GEAR-EST/SEGUIDOR-2026/README.md

# SEGUIDOR-2026

O Seguidor 2026 é um projeto de robô autonômo feito pelo [Grupo de Estudos Aplicados à Robótica (GEAR)](https://github.com/GEAR-EST) para competir na [Robocore Experience](https://www.robocoreexperience.com/) nas categorias de Seguidor de Linha ([Pro](misc/editais/Regras+-+Seguidor+de+Linha.pdf) e [Perseguidor](misc/editais/Regras+-+Perseguidor+de+Linha.pdf)).

> **Para saber mais sobre o projeto, acesse a documentação em [/docs](/docs/).**

## Organização do Repositório

```
SEGUIDOR-2026/
├── code/                       # Toda a implementação de algoritmos
│
├── docs/                       # Documentação técnica do projeto
│
├── electronics/                # Toda a parte eletrônica do robô
│
├── interface/                  # Toda a parte da interface de comunicação sem fio
│
├── mechanics/                  # Toda a parte mecânica do robô
│
├── misc/                       # Miscelânea, arquivos sem categoria definida
│
└── README.md --> ESTE ARQUIVO  # Resumo geral e organização dos diretórios
```
