GEAR-EST/SEGUIDOR-2026/misc/estudos/eletrônica/Pinout.md

Aqui está um estudo sobre o pinout como deve ser feito o diagrama de Pinout. Deve ser feito para que as constantes sejam definidas na programação e para que fique mais visível e fácil a montagem mecânica. Se possível, colocar uma descrição aos principais pinos e qual a função deles. Exemplo abaixo:

Pinout ESP32:

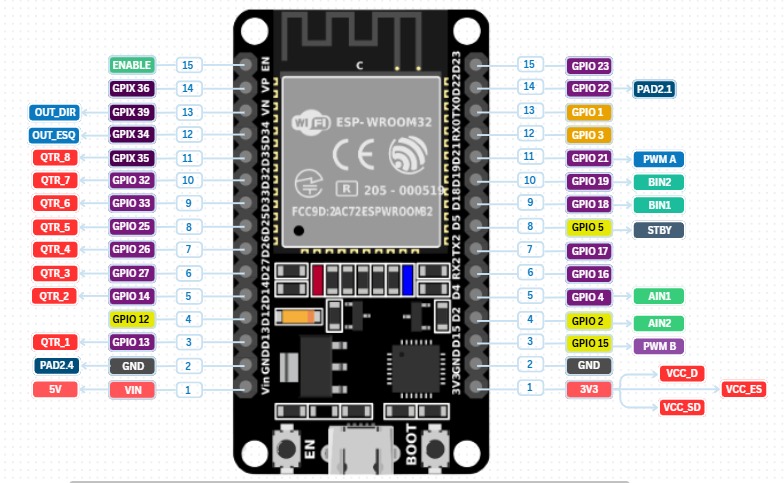
[picture p58: misc/estudos/media/img/pinnout_Esp32.jpeg]


Pinout TB6612FNG:

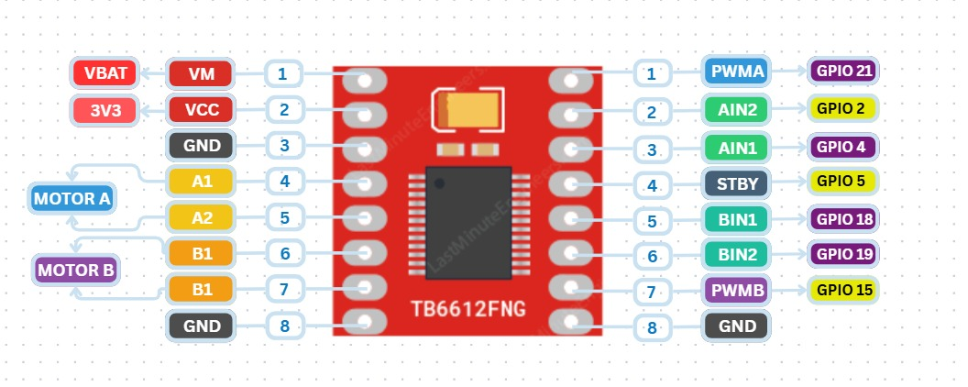
[picture p59: misc/estudos/media/img/pinout_TB6612FNG.jpeg]


Pinout Bateria LiPo 2S 7,4 V 20C 250 mAh:



Pinout Array sensor de linha QTR-8RC:

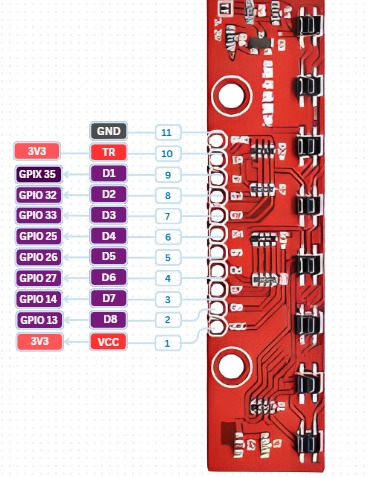
[picture p60: misc/estudos/media/img/pinout_QTR-8RC.jpeg]


Pinout TCRT5000:

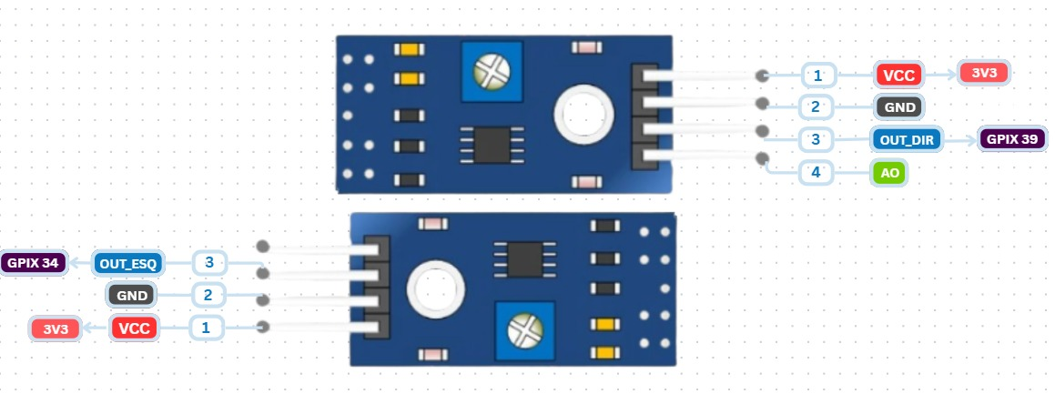
[picture p61: misc/estudos/media/img/pinout_TCRT5000.jpeg]


Pinout Motor N20 3000RPM:



Pinout Motor Coreless 8523 (7,4 V)



Pinout Transistor MOSFET IRLZ44N:



Pinout Diodo 1N4007:



Pinout Chave Switch:



Pinout Capacitores Cerâmicos e eletrolídeos:

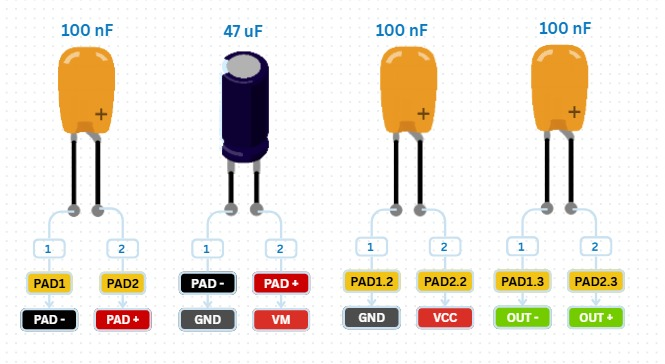
[picture p62: misc/estudos/media/img/pinout_capacitores.jpeg]


Pinout Capacitores de cerâmica dos motores:

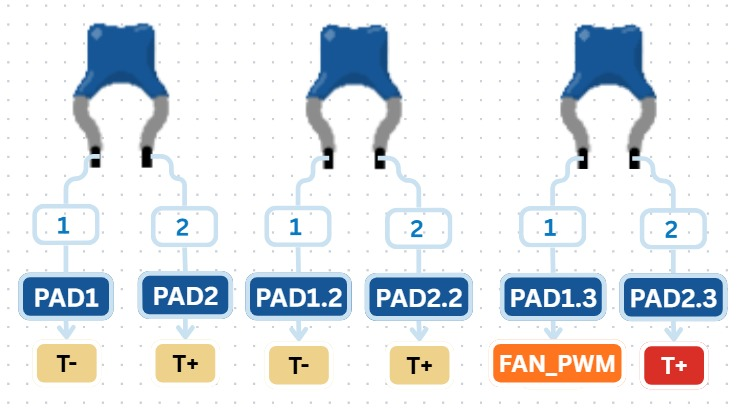
[picture p63: misc/estudos/media/img/pinout_capacitores motores.jpeg]


Pinout Resistores:

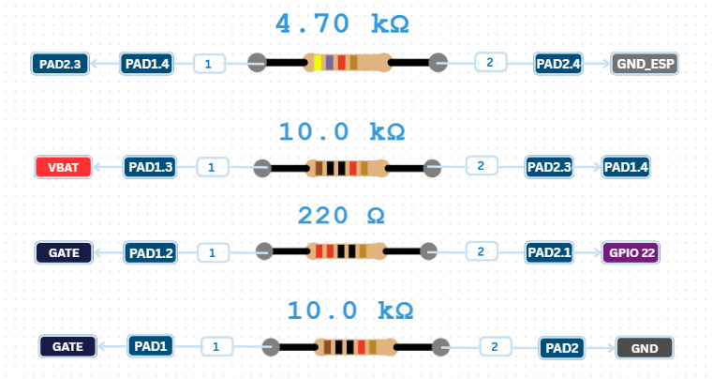
[picture p64: misc/estudos/media/img/pinout_resistores.png]


***OBS**: neste arquivo vc pode colocar mais informações e estudos sobre o pinout, quais pinos de quais componentes podem ou não ser usados e etc.*
