GEAR-EST/SEGUIDOR-2026/misc/estudos/eletrônica/EDA.md

# Estudo sobre ferramentas EDA

## O que são ferramentas EDA
Ferramentas EDA (Eletronic Design Automation) são os softwares usados para projetar circuitos elétricos que permite a criação de esquemáticos e o desenvolvimento de placas de circuito impressos (PCB). Isso ajuda a organizar o projeto e reduzir erros antes da montagem física.

## Software estudados
Em meu estudo, eu analisei três softwares que foram colocados como exemplos em minha sprint, sendo eles o EasyEDA, KiCad e o Proteus. Assistir vários vídeos no youtube mostrando como eles funcionam, suas vantagens, como mexer em suas interfaces e até de como montar os circuitos na placa. 

## O que consegui compreeender sobre o EasyEDA
O EasyEDA é um software da empresa JLC PCB, a qual podiamos fazer um pedido para nossa placa ja vim fabricada, sem o uso da máquina CNC o que facilitaria nosso trabalho e também por ser um software com layout simples, bom e leve para desenhar as placas. A primeira coisa que achei bem interessante dele foi que eu posso utilizar esse software tanto de maneira web quanto aplicativo mesmo, o que facilitaria pois eu poderia acessar os projetos da placa em qualquer computador, só bastaria logar minha conta e também pelo fato de ele ter sua versão WEB causaria menos travamentos em meu notebook. Além disso, ele também é um software totalmente gratuito com acesso a uma variedade de funções dele, Ademais, ele tem uma biblioteca em nuvem com vários componentes tanto os ja conhecidos, como também criados por outros usuários o que facilitaria no caso de achar um componente específico pois ou ja tem lá ou alguém ja criou. Ele também, além da visualização 2d eu consigo vê-lo em uma visão 3d da placa e por fim é possível gerar arquivos compatíveis com fabricação em CNC. Alguns pontos de atenção que percebi foi que o objetivo desse softare é bastante integrado a serviços de fabricação de PCB  e é menos utilizado em ambientes industriais quando comparadas a  outras ferramentas.

Links úteis: 
 - https://youtu.be/b9lXp1uWR9E?si=KflXqTHq6ku1RgbE
 - https://youtu.be/VOtHXbOfYeU?si=sdEgASXmJgM-fSaU

## O que consegui compreender sobre o KiCAD
O kiCAD já existe desde 1992 e foi desenvolvido pelo professor Jean-Pierre Charras onde ele é um software gratuito e de código aberto (totalmente open-source) onde é possível baixar funções ou componentes novos da própria comunidade que oferecem aprimoramento contínuo. Ele também possui um ecossistema completo com editor de esquemáticos, editor de PCB, visualizador 3d onde ao final eu consigo ver a placa finalizada com os componentes e as trilha, também editor de bibliotecas e ferramentas de simulação. Além disso, existe muitos materiais didáticos, tanto em português quanto em inglês, ensinando como utilizar e montar a placa no youtube, eu mesmo assisti uma playlist de vídeos de um youtuber ensinando como desenvolver do zero a placa pcb. Alguns pontos de atenção que percebi foi a curva de aprendizagem inicial onde no início como tem várias telas e ferramentas ele pode parecer difícil no início, mas acho que todos os softwares de EDA são assim, mas depois que se aprende o básico da pra usar tranquilo e até conseguir usar os outros softwares pois meio que todos seguem a mesma lógica e também ter uma certa atenção na hora de escolher os footprints para que não ocorra de o componente não encaixar na placa e assim ela ficar inutilizável.

Links úteis:
- https://youtu.be/tVLF8Y9jc6o?si=iRcJJBQs6oDxZZbI
- https://youtu.be/mX95fN_no5g?si=8gv5Y7ww7KhjM1SX

## O que consegui compreender sobre o Proteus
O Proteus foi desenvolvido pela empresa Labcenter Eletronics Ltd e é utilizado para projeto eletrônico completo. Em meu estudo, percebi que um diferencial importante desse software é a simulação de sistemas embarcados (Proteus VSM), que possibilita executar o código de microcontroladores diretamente na simulação o que ajuda a entender a lógica e interação antes da sua construção física. também é possível exportar arquivos compatíveis com fabricação profissional, como Gerber e NC Drill. Além disso, ele possui uma biblioteca extensa de componentes que acaba por facilitar a busca por um componentes específicos e a montagem de circuitos complexos. Um ponto de atenção que vi que diferente dos demais apresentados, o proteus é um software pago que requer uma licença, mas existe ali uma versão de teste de duas semanas para usa-lo, mas com alguns recursos limitados. Eu vi no relatório que na competição passada que foi utilizado o proteus para elaboração da placa, mas não soube se foi usada a versão paga ou se foi a de teste, asssim terei que me informar mais com a Natália. Outra coisa também em relação a curva de aprendizagem onde a sua interfaceé muito intregada o que pode levar um tempo para dominar, especialmente na parte da simulação.

Links úteis:
- https://youtu.be/10nSIB92kQM
- https://www.labcenter.com/
- https://youtu.be/r60dzSHzSw8
- https://youtu.be/NaFxHezsrpg?si=NwL5hcJfCe0t5rbX
