GEAR-EST/SEGUIDOR-2026/misc/estudos/eletrônica/Eletrônica.md

A eletrônica do seguidor de linha é uma das partes fundamentais para a evolução do projeto, dependendo da abordagem ela pode se tornar mais simples ou (muito) mais complexa.

Neste estudo estará sendo destacado os [Componentes](./Componentes.md) que serão usados no robô; uma descrição dos pinos dos componentes em [Pinout](./Pinout.md) e, por fim, uma discussão acerca das vantagens e desafios de fazer uma [PCB](./PCB.md) profissional. 

É recomendado para a criação do diagrama de pinout o site [app.cirkitdesigner.com](https://app.cirkitdesigner.com/), veja abaixo o início do projeto da eletrônica do Seguidor 2026:



Veja esse projeto no link: [https://app.cirkitdesigner.com/project/e0f3b528-745b-463c-b46d-99f20715ee49](https://app.cirkitdesigner.com/project/e0f3b528-745b-463c-b46d-99f20715ee49)
