GEAR-EST/SEGUIDOR-2026/misc/estudos/inspirações e referências/Outras Referências.md

Aqui estará listadas outras fontes de informação e referências para o desenvolvimento do Seguidor de Linha.

- Projetos de Seguidor:
	- Zé do ZigZag, da Equipe GEAR - https://github.com/GEAR-projects/SEGUIDOR_PRO_2025/
	- Raijin, da Equipe Raiju - https://raiju.team/projects/raijin
	- Tracer, da Equipe ThundeRatz - https://thunderatz.org/projects/robots/tracer
	- Apollon, de Shachiku Hakase (campeão japonês) - http://ak-rcroom.com/sakuhin/robotrace/robotrace_2024/
	- Ártemis e Nêmesis, da Equipe Trincabotz - [Follow_Trincabotz.pdf](../media/pdf/Follow_Trincabotz.pdf)
	- Fujitora, da Equipe OPRobot (campeão espanhol) https://github.com/OPRobots/FujitoraBot

- Vídeos:
	- Aulão com dicas importantes - https://drive.google.com/drive/folders/1ZtTLXdNQbpcHHgfRA_H44VTmFx3YXYoj
	- Visão geral de Micromouse - https://www.youtube.com/watch?v=gsc4eETwRCs
	- Canal de Shachiku Hakase (campeão japones) - https://www.youtube.com/@ShachikuHakase
	- Detecção de cruzamentos - https://www.youtube.com/watch?v=Suel9Q8h0Bg
	
- GitHub:
	- Equipe Raiju - https://github.com/team-raiju
	- Equipe ThundeRatz - https://github.com/ThundeRatz
	- Equipe Kakarobot - https://github.com/kakarobot
	- Open Lamborghino - https://github.com/AndresBercovich/OpenLamborghino

- Simuladores:
	- Equipe Phoenix - https://github.com/Koyoman/robotrace_Sim (demonstração: https://www.youtube.com/watch?v=kTXd0tmnem0)
	- Equipe Raiju - https://github.com/team-raiju/line-follower-simulator
	- Equipe ThunderRatz - https://github.com/ThundeRatz/FollowerTrackCreator
	
- GrabCad (Modelos 3D): 
	- Equipe Paralela - https://grabcad.com/library/raven-vf1-robotracer-line-follower-1
	- Independente - https://grabcad.com/library/seguidor-de-linha-rapadura-nitro-v4-1

- Sucção:
	- OPRobots - https://github.com/OPRobots/Centrifugal-Suction-Fan
	- Robotrace (japonês) - https://rt-net.jp/mobility/archives/20965
	- Robotrace 2 (japonês) - https://rt-net.jp/mobility/archives/20965
