GEAR-EST/SEGUIDOR-2026/misc/estudos/mecânica/Mecânica.md

A mecânica do seguidor é de certa forma bem simples, dividida em apenas duas partes: o corpo e a cabeça. 

Não há tantas restrições quanto à estrutura mecânica em si, como dimensões (máx. 250 x 250 x 200 mm) ou peso (sem limite). 

Para ver mais detalhes sobre a Estrutura Mecânica e suas funcionalidades específicas, veja [Chassi](./Chassi.md).
