GEAR-EST/SEGUIDOR-2026/misc/estudos/mecânica/Transmissão 4x2.md

A transmissão 4x2 se trata de uma transmissão de 4 rodas e 2 motores. Os motores são conectados a um pinhão que transmite o movimento em redução com engrenagens para as rodas. Abaixo é possível visualizar como isso ocorre. As vantagens de se utilizar esse sistema de transmissão de movimento é para que o robô tenha mais estabilidade durante as curvas e que tenhamos mais precisão quanto à sua velocidade.

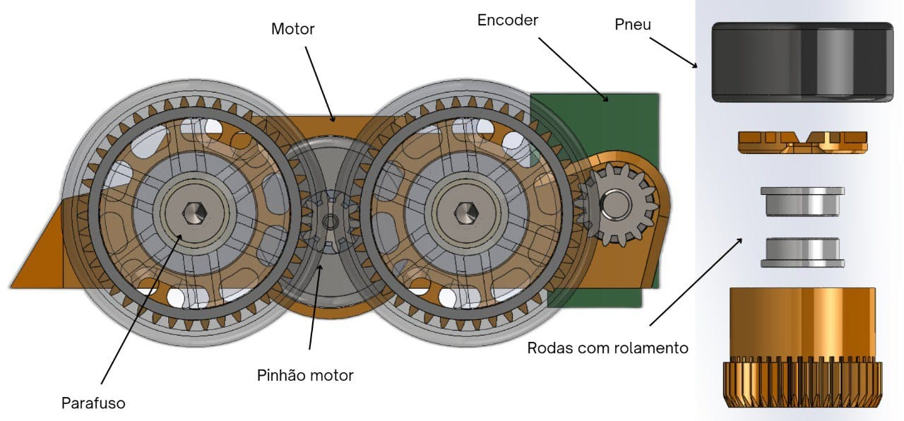
[picture p71: misc/estudos/media/img/4x2_teoria.jpeg]


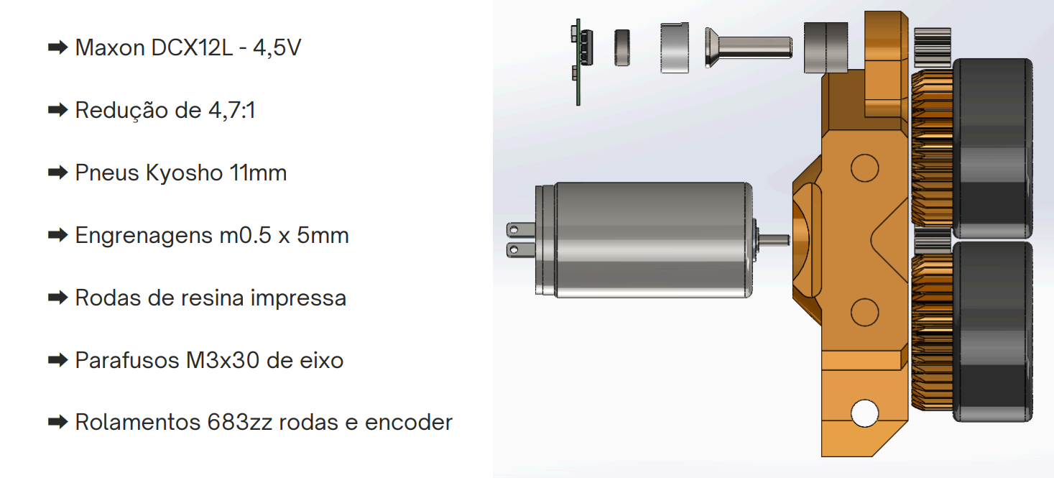
[picture p72: misc/estudos/media/img/especificacoes_locomocao.png]


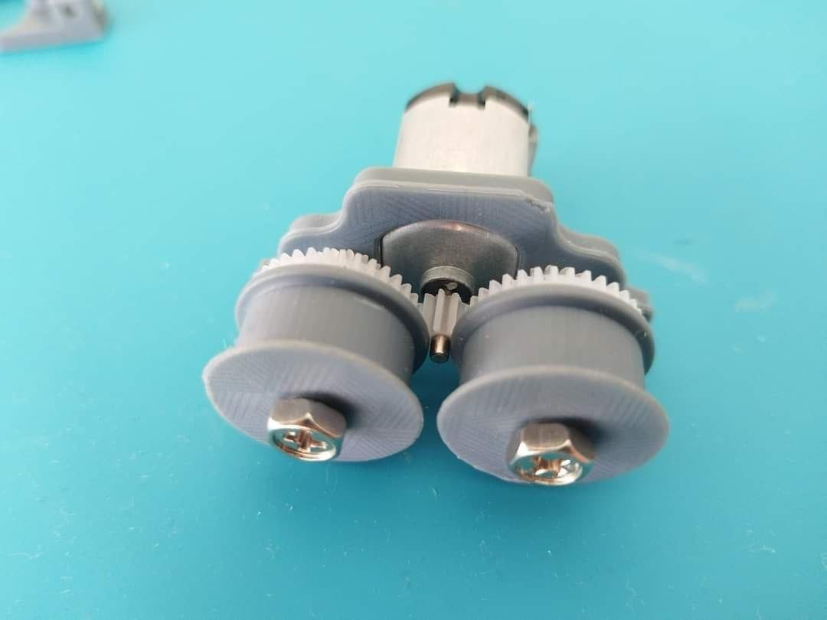
[picture p73: misc/estudos/media/img/4x2_real.jpeg]


Uma melhor explicação sobre a locomoção do seguidor pode ser vista em [Apresentação_Phoenix.pdf](../media/pdf/Apresentação_Phoenix.pdf).
