GEAR-EST/SEGUIDOR-2026/misc/estudos/media/pdf/Apresentação_Phoenix.pdf

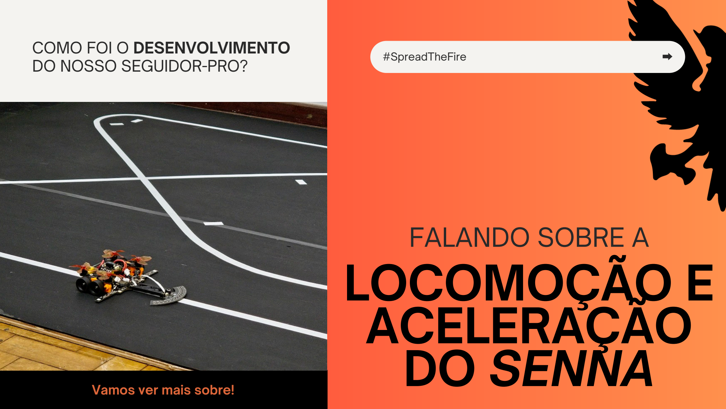
[picture p76: page 1]

Vamos ver mais sobre!

#SpreadTheFire | ➡ COMO FOI O DESENVOLVIMENTO

DO NOSSO SEGUIDOR-PRO?

# FALANDO SOBRE A

# LOCOMOÇÃO E ACELERAÇÃO DO SENNA

H

I

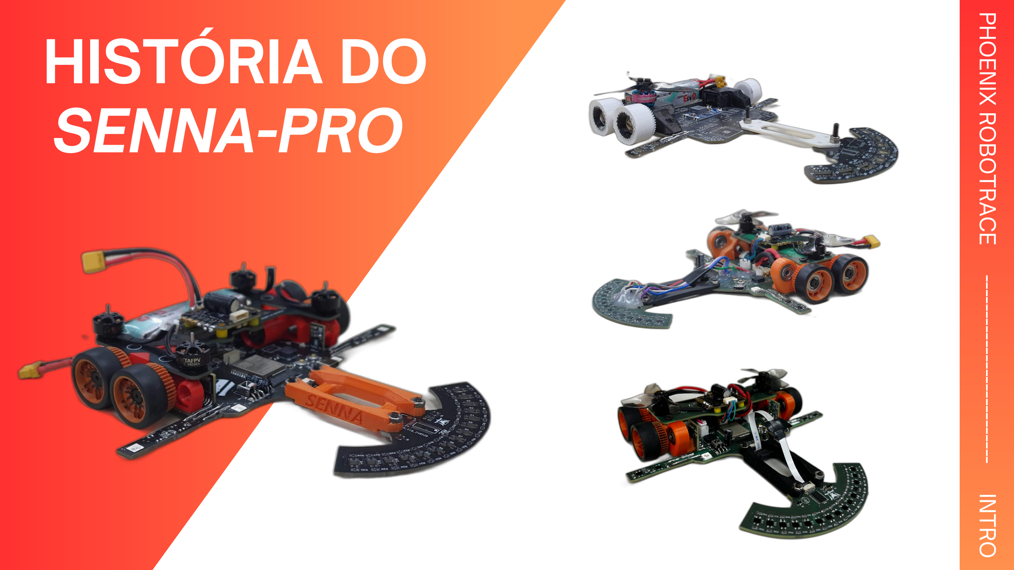
[picture p77: page 2]

PHOENIX ROBOTRACE -------------------------- INTRO
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
# ENNA

PR

O

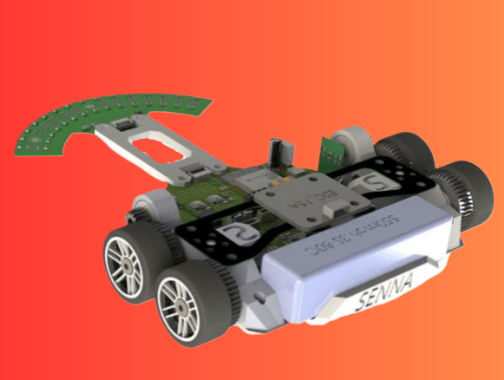
[picture p78: figure]

PHOENIX ROBOTRACE ------------ LOC.

# COMO PROJETAR UMA LOCOMOÇÃO

4X2

Escolha de motor

Os motores coreless de tamanho 1020 até 1330 são os mais comuns. Sempre que possível escolha um motor que seja possível aplicar overvoltage
Relação de redução

A relação de redução se dá através da divisão do número de dentes da engrenagem motora e movida, ou seja:

Com o motor definido é possível estimar a velocidade linear máxima do projeto através da fórmula:

Validação do sistema

Com base nas engrenagens escolhidas, é necessário fazer os ajustes de tolerância para garantir que o sistema rode sem travamento.

L

O

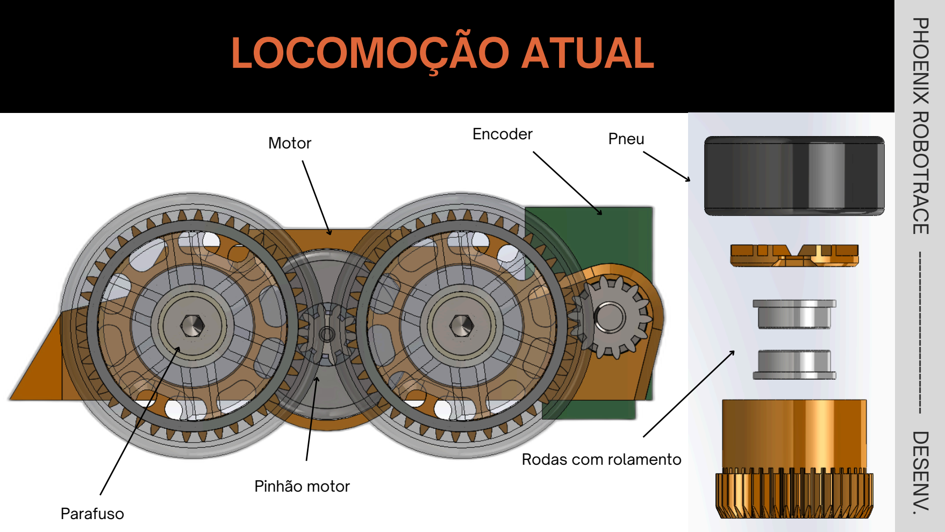
[picture p79: page 4]

COMBAT ROBOTS ---------------------------- JAMANTA PHOENIX ROBOTRACE ------------------------ DESENV. Motor

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
# ESPECIFICAÇÕES DA LOCOMOÇÃO

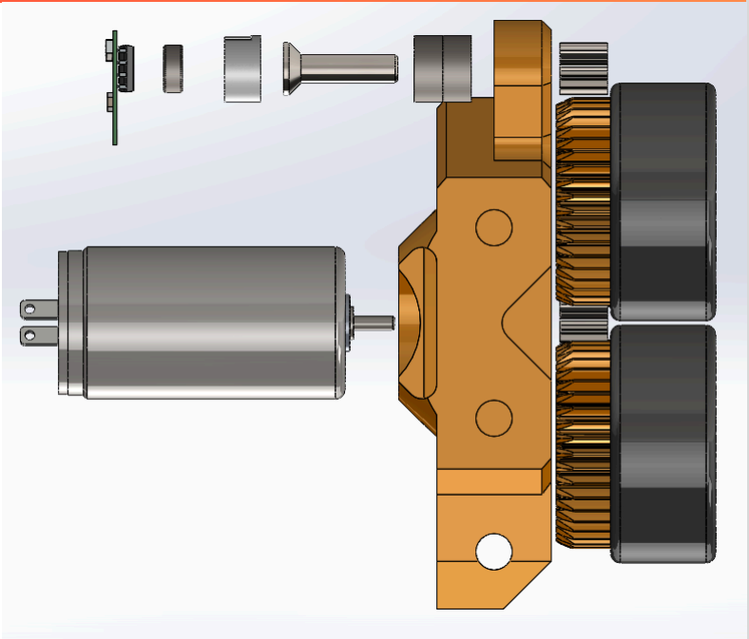
[picture p80: figure]

➡ Maxon DCX12L - 4,5V

➡ Redução de 4,7:1

➡ Pneus Kyosho 11mm

➡ Engrenagens m0.5 x 5mm

➡ Rodas de resina impressa

➡ Parafusos M3x30 de eixo

➡ Rolamentos 683zz rodas e encoder

# ROTINAS DE ACELERAÇÃO SEM ENCODER

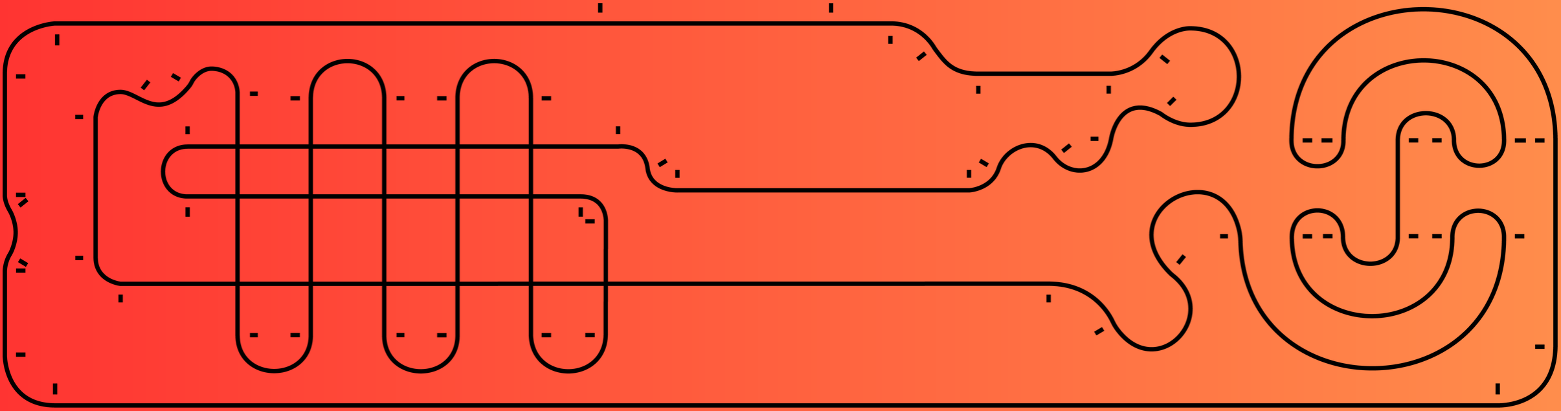
[picture p81: figure]

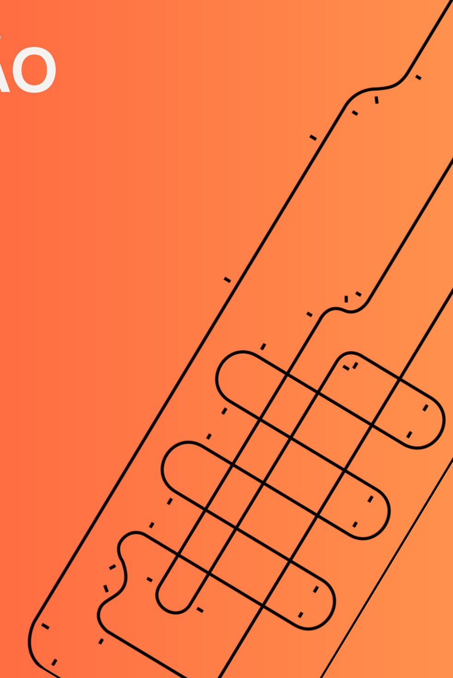
[picture p82: figure]

# ROTINAS DE ACELERAÇÃO

São usadas em trechos onde o robô pode desenvolver uma velocidade elevada sem risco de derrapar (longas retas ou curvas abertas).

Envolvem definir tais trechos na pista (setorizá-la) e parametrizar as características dessa aceleração (intensidade, duração, etc.)

# ROTINAS DE ACELERAÇÃO SEM ENCODER

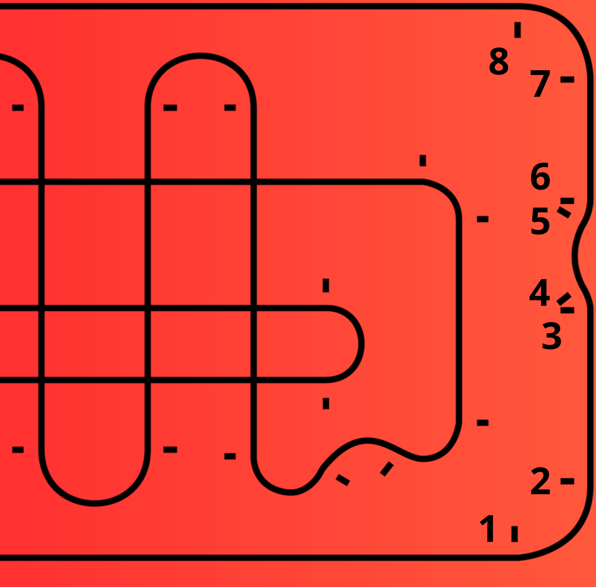
[picture p83: figure]

Ideia principal: Contar os marcadores de curva ao longo do percurso
Usá-los para setorizar a pista
Definir em quais trechos os parâmetrros do robô vão ser alterados
Velocidade máxima
Potência das hélices (se houver) Duração da aceleração

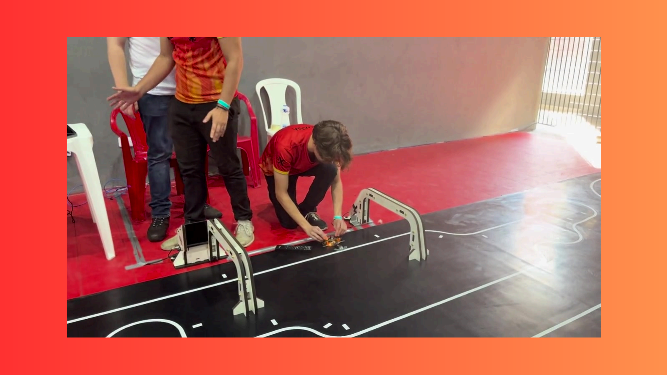
[picture p84: page 9]

40% | 40% | 70% | 40% | 20% | ... | 40%

# ROTINAS DE ACELERAÇÃO SEM ENCODER

motor_velocity

0 | 1 | 2 | 3 | 4 | ... | N
45% | 45% | 15% | 45% | 65% | ... | 45% esc_velocity
0 | 1 | 2 | 3 | 4 | ... | N
0 | 0 | 2s | 0 | 1s | ... | 0 acce_duration
0 | 1 | 2 | 3 | 4 | ... | N

40% | 40% | 70% | 40% | 20%
0 | 1 | 2 | 3 | 4

# ROTINAS DE ACELERAÇÃO SEM ENCODER

motor_velocity

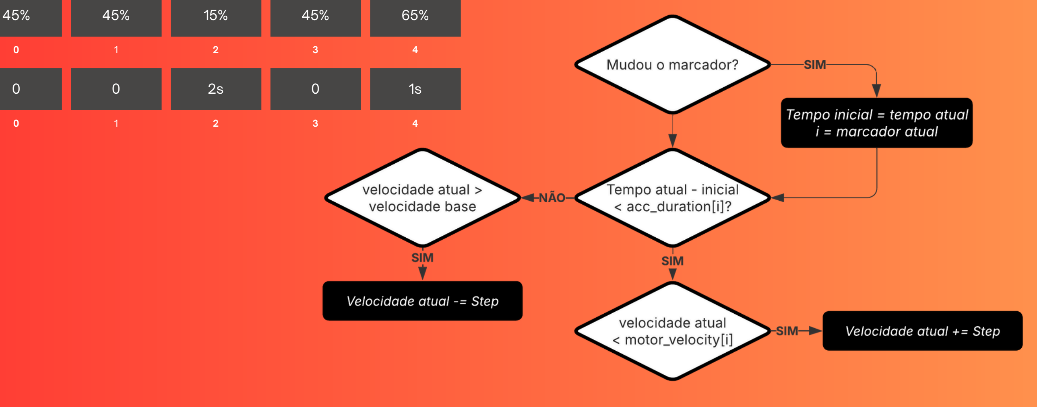
[picture p85: figure]

esc_velocity

acc_duration

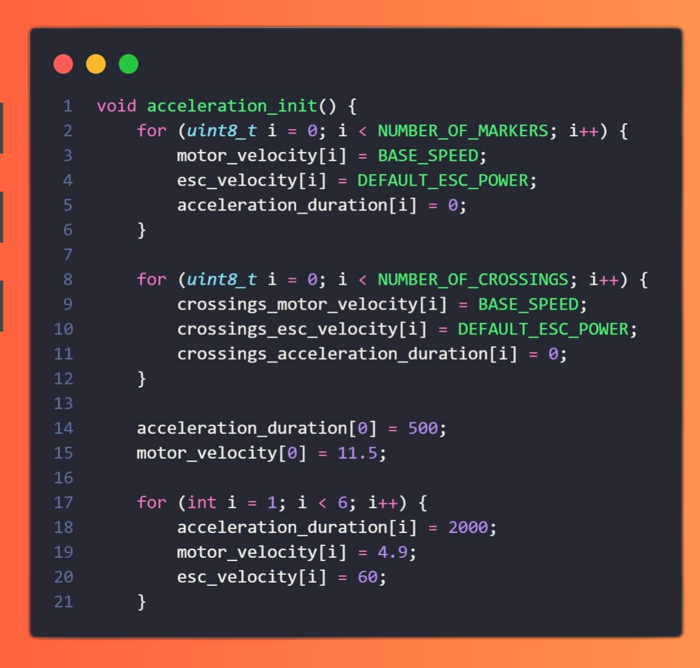
[picture p86: figure]

40% | 40% | 70% | 40% | 20%
0 | 1 | 2 | 3 | 4
45% | 45% | 15% | 45% | 65%
0 | 1 | 2 | 3 | 4
0 | 0 | 2s | 0 | 1s
0 | 1 | 2 | 3 | 4

# ROTINAS DE ACELERAÇÃO SEM ENCODER

motor_velocity

esc_velocity

acc_duration

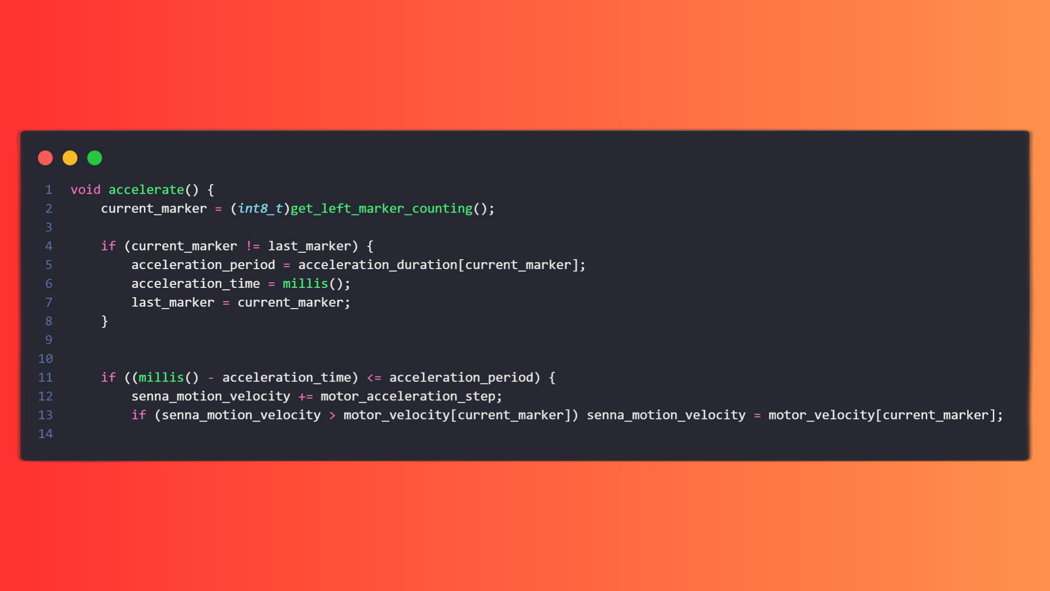
[picture p87: page 13]

# ROTINAS DE ACELERAÇÃO SEM ENCODER

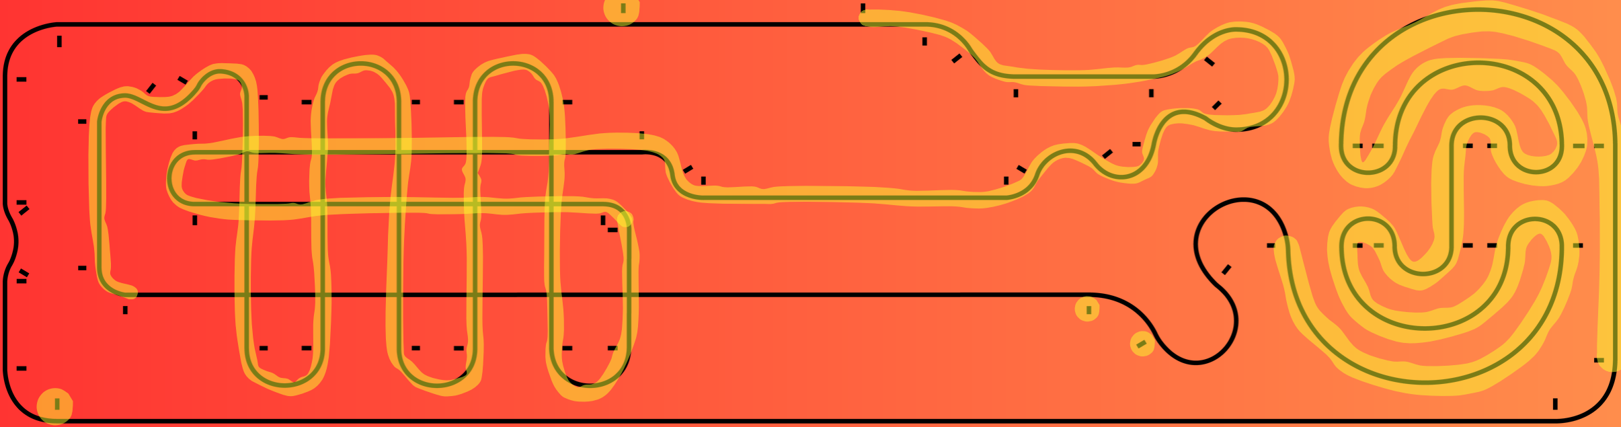
[picture p88: figure]

# ROTINAS DE ACELERAÇÃO SEM ENCODER

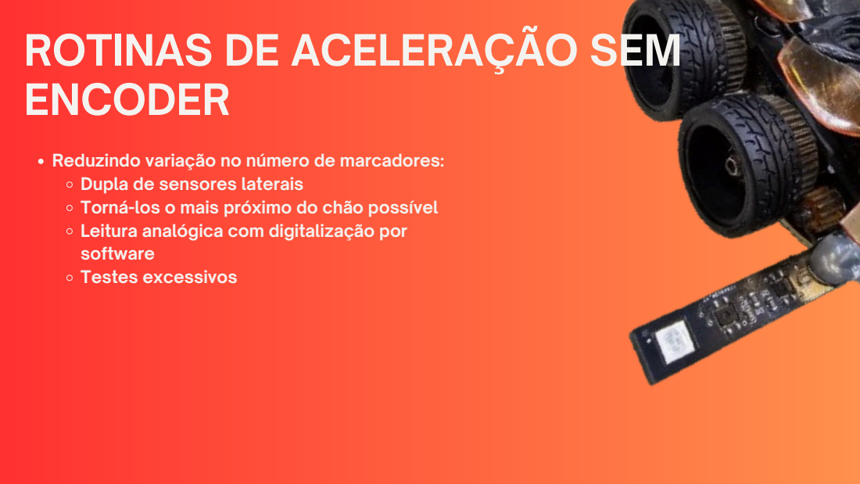
[picture p89: page 15]

Reduzindo variação no número de marcadores:
Dupla de sensores laterais
Torná-los o mais próximo do chão possível
Leitura analógica com digitalização por
software
Testes excessivos

O

B

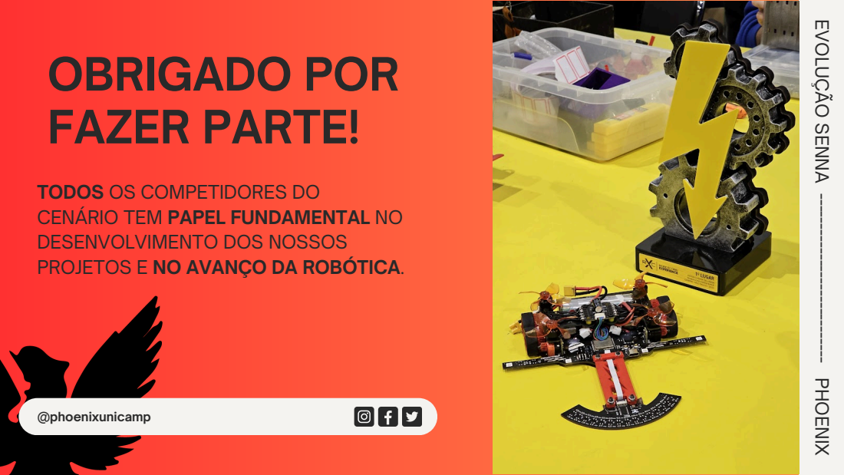
[picture p90: page 16]
TID; RIO; VIM

EVOLUÇÃO SENNA ---------------------------- PHOENIX
