GEAR-EST/SEGUIDOR-2026/misc/README.md

> *OBS: Este arquivo (README.md) deve ser excluído. Então mesmo que não tenha a seguir textos em itálico, este arquivo por completo deve ser excluído*

--

# Diretório de Miscelânea

Este diretório deve conter arquivos diversos que não se encaixam nas outras categorias principais do projeto, como por exemplo:

- Regulamentos das competições
- Templates de documentos
- Referências bibliográficas
- Guias e tutoriais externos
- Materiais de apresentação, slide
- Fotos e vídeos diversos

## Organização Sugerida

1. Mantenha os arquivos organizados em subpastas por categoria
2. Inclua uma breve descrição para cada arquivo não óbvio
3. Mantenha versões atualizadas dos regulamentos

## Observação

Este diretório não deve ser usado como "pasta geral" - apenas para arquivos que realmente não se encaixam nas outras categorias específicas do projeto.
