GEAR-EST/SEGUIDOR-2026/misc/estudos/inspirações e referências/Equipes de Referência.md

Algumas equipes (tanto brasileiras quanto internacionais) são referências na área de seguidor de linha, e nada melhor que se inspirar neles para fazer nosso robô.

Nacionais (e concorrentes na RCX):
1. Equipe Raiju (USP) - https://raiju.team/
2. ThundeRatz (USP) - https://thunderatz.org/
3. Equipe Paralela (Unicamp) - https://www.instagram.com/equipeparalela
4. Equipe Phoenix (Unicamp) - https://www.instagram.com/phoenixunicamp/
5. Equipe Trincabotz (CEFET-MG) - https://www.instagram.com/trincabotz/

Internacionais:
1. Equipe Kakarobot (Indonésia) - www.instagram.com/kakarobot
2. Shachiku Hakase (Japão) - http://ak-rcroom.com/
3. Open Lamborghino (Chile) - https://lamborghino.com/
4. OPRobots (Espanha) - https://oprobots.org/
