GEAR-EST/SEGUIDOR-2026/misc/estudos/inspirações e referências/Inspirações.md

Aqui estão algumas imagens de robotrace japoneses para servir de inspiração para o desenvolvimento do nosso seguidor de linha. Veja também: [Equipes de Referência](./Equipes%20de%20Referência.md), [Outras Referências](./Outras%20Referências.md).

<div style="text-align: center;">
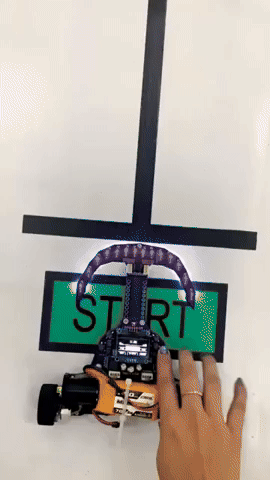
[picture p120: misc/estudos/media/img/line_follower.gif]
     <br>
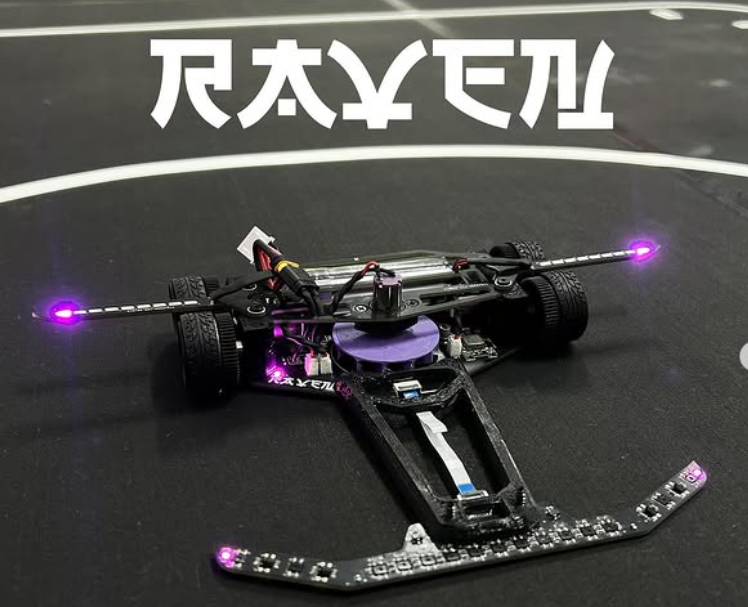
[picture p121: misc/estudos/media/img/insp_1.png]
     <br>
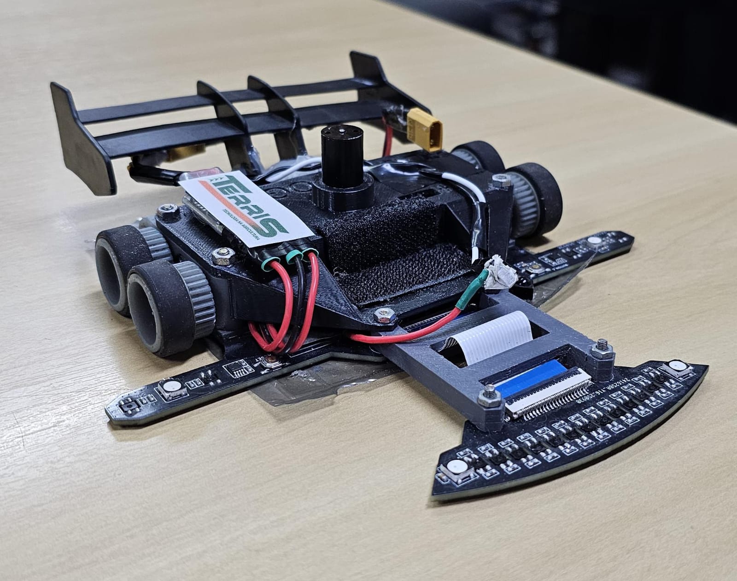
[picture p122: misc/estudos/media/img/insp_2.jpeg]
     <br>
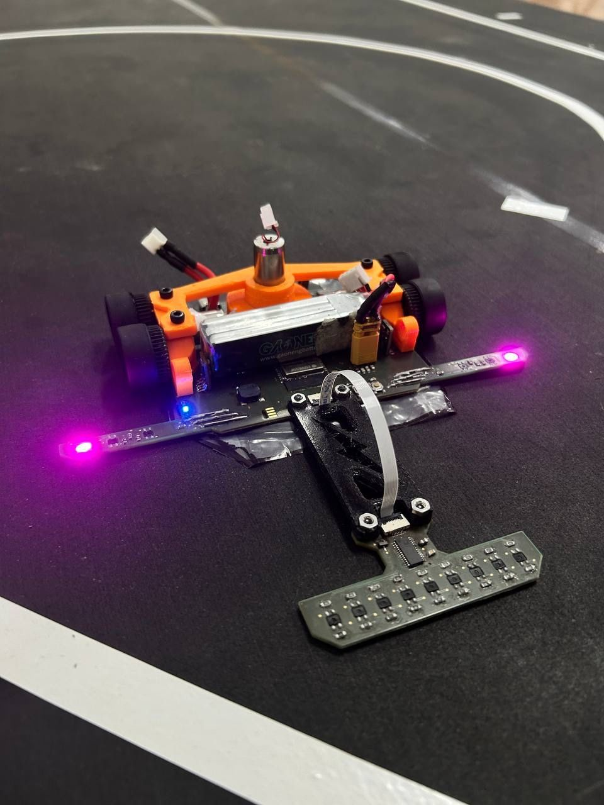
[picture p123: misc/estudos/media/img/insp_3.png]
     <br>
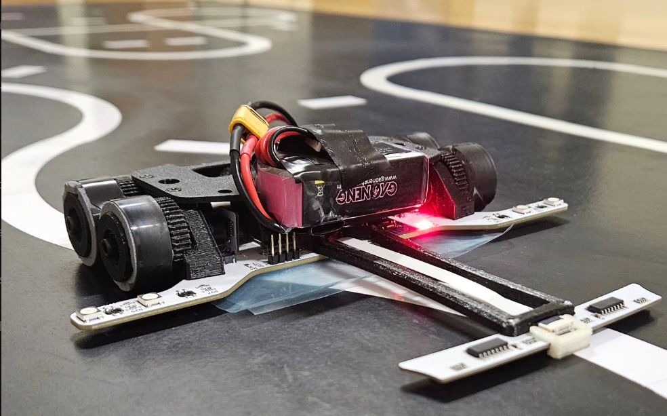
[picture p124: misc/estudos/media/img/insp_4.png]
     <br>
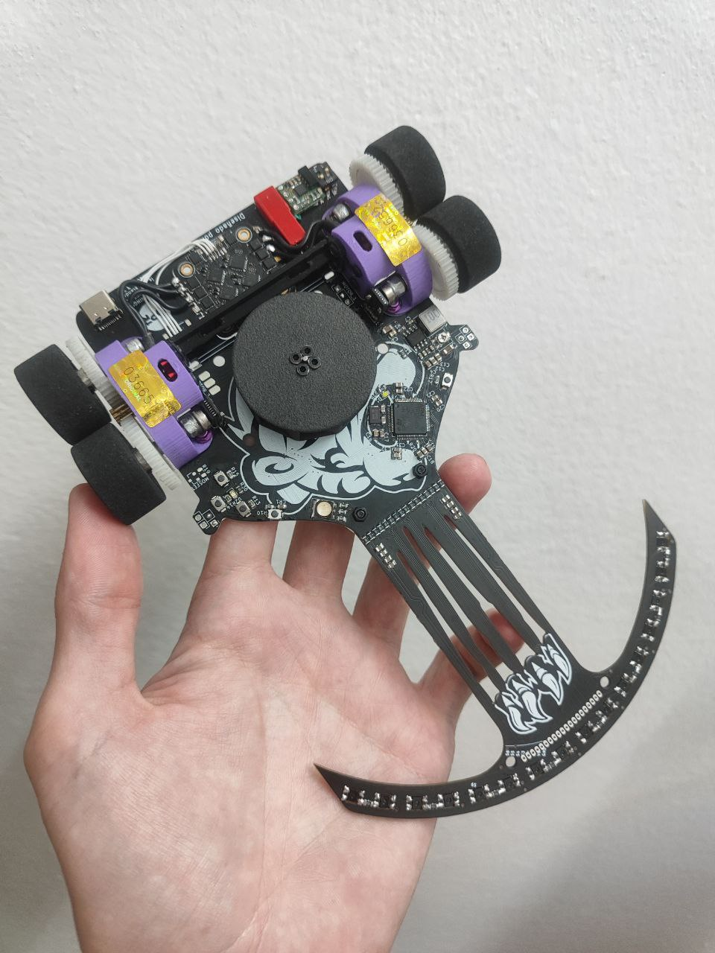
[picture p125: misc/estudos/media/img/insp_5.png]
     <br>
</div>
