GEAR-EST/SEGUIDOR-2026/misc/estudos/lógica de controle/files/Capacitação Embarcados - PlatformIO.pdf

UNIVERSIDADE DO ESTADO DO AMAZONAS ESCOLA SUPERIOR DE TECNOLOGIA GRUPO DE ESTUDOS APLICADOS À ROBÓTICA

CÉLIO BENJAMIM


CAPACITAÇÃO EM SISTEMAS EMBARCADOS: PlatformIO

Manaus - AM
2025

## 1. O Que é o PlatformIO?

No universo do desenvolvimento de sistemas embarcados, a transição de projetos simples para soluções complexas e profissionais exige ferramentas que ofereçam poder, flexibilidade e eficiência. O PlatformIO surge como uma resposta a essa necessidade, posicionando-se não apenas como uma alternativa, mas como uma evolução fundamental no modo como engenheiros e desenvolvedores criam produtos para a Internet das Coisas (IoT).

### 1.1. Ecossistema PlatformIO

É crucial compreender que o PlatformIO não é um editor de código ou um Ambiente de Desenvolvimento Integrado (IDE) monolítico. Ele é um ecossistema de código aberto, multiplataforma e profissional, projetado especificamente para o desenvolvimento de software embarcado. Sua principal função é unificar e simplificar o processo de desenvolvimento para uma vasta gama de microcontroladores, placas e frameworks de software.

A implementação mais popular e amada do PlatformIO é sua extensão para o Microsoft Visual Studio Code (VS Code), um editor de código moderno, gratuito e altamente extensível. Essa integração transforma o VS Code em um poderoso IDE para sistemas embarcados, combinando um editor de classe mundial com as ferramentas especializadas do PlatformIO.

O ecossistema é sustentado por dois componentes centrais que trabalham em harmonia:

- PlatformIO Core (CLI): Considerado o coração de todo o sistema, o Core é uma ferramenta de linha de comando (Command Line Interface) escrita em Python puro. Ele é completamente autônomo e não depende de softwares adicionais do sistema operacional, o que garante sua portabilidade. O Core é responsável por todas as operações fundamentais: o sistema de compilação (build system), o gerenciamento de plataformas e bibliotecas, e a integração com sistemas de automação.
- PlatformIO IDE: Esta é a camada de interface gráfica que se constrói sobre o PlatformIO Core. Ao ser instalada como uma extensão no VS Code, ela oferece uma experiência de usuário rica e intuitiva, com botões, menus e assistentes que abstraem a complexidade da linha de comando para o fluxo de trabalho diário.

Essa arquitetura dual, que separa a lógica de automação (Core) da interface de usuário (IDE), é a base da flexibilidade do PlatformIO. Desenvolvedores iniciantes podem se beneficiar de uma interface gráfica amigável para criar e carregar projetos, enquanto equipes avançadas podem utilizar o mesmo Core CLI em servidores de Integração Contínua (CI) para automatizar compilações, testes e implantações, adotando práticas de DevOps modernas no mundo embarcado.

### 1.2. A Filosofia da plataforma

A filosofia do PlatformIO é encapsulada em seu lema: "No more vendor lock-in!" (Chega de aprisionamento ao fornecedor). Tradicionalmente, cada fabricante de microcontrolador (Atmel, Espressif, STMicroelectronics, etc.) exigia seu próprio IDE, seu próprio conjunto de compiladores (toolchain) e suas próprias bibliotecas, forçando os desenvolvedores a aprender um novo ambiente para cada hardware diferente. O PlatformIO quebra esse paradigma.

Ele traz para o desenvolvimento embarcado princípios de engenharia de software moderna, como:

- Princípios Declarativos: Através do arquivo de configuração platformio.ini, o desenvolvedor declara qual placa, framework e bibliotecas o projeto necessita. O PlatformIO se encarrega de baixar, instalar e configurar todo o ambiente automaticamente.
- Metodologias Orientadas a Testes: O ecossistema possui suporte nativo para testes de unidade, permitindo a verificação da lógica do software tanto no computador host quanto no hardware de destino.
- Toolchains Modernas: Ele gerencia cadeias de ferramentas de compilação atualizadas para dezenas de arquiteturas de hardware, garantindo que o desenvolvedor sempre tenha acesso a compiladores otimizados e recursos modernos.

O resultado prático dessa filosofia é a capacidade de compilar o mesmo código-fonte para diferentes plataformas de hardware com um único comando (platformio run), uma mudança de paradigma que acelera drasticamente a prototipagem e a produção. Essa abordagem não é apenas uma conveniência técnica; ela atua como uma força democratizadora no mercado de hardware. Ao padronizar o processo de desenvolvimento, o PlatformIO reduz a barreira de entrada para novas placas e fabricantes, permitindo que os desenvolvedores experimentem e adotem novo hardware com atrito mínimo, o que, por sua vez, fomenta a inovação e a competição em todo o setor de microcontroladores.

## 2. Vantagens

A decisão de adotar uma nova ferramenta de desenvolvimento deve ser justificada por ganhos claros em produtividade, qualidade e capacidade. O PlatformIO oferece um conjunto de vantagens estratégicas que o posicionam como a evolução natural para qualquer desenvolvedor que busca ir além das limitações de ambientes mais básicos, como a IDE do Arduino.

### 2.1. Evolução do Arduino IDE

A IDE do Arduino é uma ferramenta excepcional para iniciantes, oferecendo uma curva de aprendizado suave e uma interface simples para projetos básicos. No entanto, à medida que os projetos crescem em complexidade, suas limitações se tornam evidentes, especialmente em áreas como gerenciamento de dependências, depuração e recursos de edição de código.

O PlatformIO representa o próximo passo nessa jornada. Análises comparativas de mercado mostram que o PlatformIO consistentemente supera a IDE do Arduino em categorias críticas para o desenvolvimento profissional. Usuários relatam uma experiência de onboarding mais polida, um sistema de gerenciamento de arquivos muito mais robusto e eficaz para grandes projetos, e um suporte superior a múltiplas linguagens de programação.

### 2.2. Desenvolvimento Inteligente e Produtivo

O PlatformIO eleva a experiência de codificação ao integrar recursos inteligentes diretamente no editor:

- Intelligent Code Completion e Linting: O editor oferece sugestões de autocompletar de código baseadas em tipos de variáveis, definições de funções e bibliotecas incluídas. Isso não apenas acelera a escrita do código, mas também reduz drasticamente os erros de digitação e sintaxe. Simultaneamente, o linting (análise de código em tempo real) sublinha potenciais erros e problemas de estilo enquanto o código é escrito, permitindo correções antes mesmo da compilação.
- Análise Estática de Código: O PlatformIO integra ferramentas de análise estática que examinam o código-fonte em busca de bugs comuns, vulnerabilidades de segurança e violações de padrões de codificação. Identificar esses problemas no início do ciclo de desenvolvimento é uma prática profissional que economiza tempo e aumenta a robustez e a segurança do produto final.

### 2.3. Gerenciamento de Bibliotecas e Dependências

Um dos maiores desafios em projetos embarcados é o gerenciamento de bibliotecas. A abordagem da IDE do Arduino, com bibliotecas instaladas globalmente, frequentemente leva a conflitos de versão e dificulta o compartilhamento de projetos, gerando o clássico problema "funciona na minha máquina".

O PlatformIO resolve isso com um sistema de gerenciamento de dependências declarativo e por projeto. Através da diretiva lib_deps no arquivo platformio.ini, o desenvolvedor especifica exatamente quais bibliotecas e em quais versões o projeto necessita. O PlatformIO então gerencia o download e a utilização dessas versões específicas para aquele projeto, garantindo um ambiente de compilação 100% reprodutível em qualquer computador. Com acesso a um registro de mais de 13.000 bibliotecas, encontrar e integrar funcionalidades externas torna-se uma tarefa trivial e segura. Este sistema é a base que torna a colaboração em equipe, especialmente quando combinada com sistemas de controle de versão como o Git, viável e confiável. O platformio.ini age como um "contrato" que define o ambiente do projeto, eliminando ambiguidades.

### 2.4. Depuração e Testes

A depuração profissional é talvez a vantagem mais transformadora do PlatformIO. Enquanto o método tradicional no mundo Arduino se baseia em Serial.print(), o PlatformIO oferece o PIO Unified Debugger. Esta ferramenta permite a depuração real "on-chip" (diretamente no microcontrolador) com suporte para centenas de placas, muitas vezes sem necessidade de configuração adicional ("zero-configuration"). O desenvolvedor pode:

- Definir breakpoints para pausar a execução do código em pontos específicos.
- Inspecionar o valor de variáveis em tempo real (watch windows).
- Analisar a pilha de chamadas de funções (call stack) para entender o fluxo do programa.

Essa capacidade de depuração é ordens de magnitude mais eficiente e poderosa do que a depuração por impressão serial. Além disso, o PlatformIO integra um framework para Testes de Unidade (Unit Testing), permitindo que os desenvolvedores escrevam testes para validar componentes individuais do software, garantindo a qualidade e a confiabilidade do código de forma automatizada.

### 2.5. Ecossistema Abrangente e Flexível

A flexibilidade do PlatformIO é incomparável. Ele suporta mais de 40 plataformas de desenvolvimento (que representam famílias de microcontroladores como ESP32, STM32, AVR, etc.), mais de 20 frameworks de software (incluindo Arduino, ESP-IDF, Zephyr, Mbed) e mais de 1.500 placas de desenvolvimento diferentes. Isso significa que um desenvolvedor pode usar a mesma ferramenta e o mesmo fluxo de trabalho para programar um ESP32 com o framework Arduino, depois mudar para um STM32 usando as bibliotecas HAL, e em seguida trabalhar em um projeto com um Nordic nRF52 usando o sistema operacional Zephyr, tudo dentro do mesmo ambiente familiar.

Ao introduzir essas ferramentas e práticas — depuração unificada, testes de unidade, análise estática e gerenciamento declarativo de dependências — o PlatformIO está efetivamente importando as melhores práticas da engenharia de software moderna para o domínio embarcado. Isso representa uma mudança cultural, transformando o desenvolvimento embarcado de uma disciplina focada primariamente no hardware para uma disciplina robusta e centrada no software. Um desenvolvedor que domina o PlatformIO não está apenas aprendendo a programar um chip; está se tornando um engenheiro de software qualificado para construir os sistemas complexos, conectados e seguros que a era da IoT exige.

## 3. Guia de Instalação

A instalação do PlatformIO é um processo direto, focado na integração com o Visual Studio Code. Este guia passo a passo garantirá que seu ambiente de desenvolvimento esteja configurado e pronto para uso.

### 3.1. Pré-requisitos

Antes de instalar a extensão do PlatformIO, dois componentes de software devem estar presentes em seu sistema:

- Microsoft Visual Studio Code (VS Code): O PlatformIO IDE funciona como uma extensão dentro do VS Code. É necessário baixar e instalar a versão estável mais recente diretamente do site oficial: https://code.visualstudio.com/. O instalador está disponível para Windows, macOS e Linux.
- Python: O coração do PlatformIO, o Core, é escrito em Python. Embora a extensão do VS Code geralmente instale sua própria versão portátil de Python, é uma boa prática ter o Python 3.5 ou superior instalado no sistema.

Em sistemas Linux, é particularmente importante garantir que o pacote python3-venv esteja instalado, pois ele é essencial para a criação de ambientes virtuais que o PlatformIO utiliza.

A decisão estratégica de construir o PlatformIO como uma extensão para o VS Code foi um fator crucial para sua rápida e ampla adoção. Ao invés de criar um IDE do zero, o PlatformIO se integrou a um editor de código já extremamente popular, de código aberto e com um vasto ecossistema. Isso permitiu que o PlatformIO herdasse instantaneamente recursos de edição de alta qualidade e uma interface familiar para milhões de desenvolvedores, tornando a instalação tão simples quanto adicionar qualquer outra extensão e reduzindo significativamente a curva de aprendizado.

### 3.2. Instalando a Extensão PlatformIO

Com os pré-requisitos atendidos, a instalação da extensão é realizada em poucos passos dentro do VS Code:

1. Abra o Visual Studio Code.
2. Acesse o Gerenciador de Extensões: Na barra de atividades à esquerda, clique no ícone que se parece com quatro quadrados (Extensions), ou utilize o atalho de teclado Ctrl+Shift+X.
3. Pesquise pela Extensão: Na barra de busca que aparece, digite "PlatformIO IDE".
4. Instale a Extensão Oficial: Identifique a extensão publicada oficialmente pela PlatformIO e clique no botão "Install".

O processo de instalação pode levar alguns minutos. Durante esse tempo, o VS Code estará baixando não apenas a extensão, mas também o PlatformIO Core e todas as suas dependências em segundo plano. É importante aguardar a conclusão do processo.

Após a conclusão da instalação, alguns novos elementos devem aparecer na interface do VS Code, confirmando o sucesso da operação:

- Um ícone da cabeça de uma formiga (o logo do PlatformIO) aparecerá na barra de atividades à esquerda.
- Uma nova aba intitulada "PlatformIO Home" deve abrir, apresentando a tela inicial com opções como "New Project", "Open Project", etc.
- Uma barra de ferramentas com ícones para tarefas comuns (Build, Upload, Serial Monitor) aparecerá na barra de status azul na parte inferior da janela.

Se esses elementos não aparecerem imediatamente, uma simples reinicialização do VS Code geralmente resolve o problema e completa a configuração.

## 4. Utilizando o PlatformIO

Com o ambiente devidamente configurado, o próximo passo é aprender o fluxo de trabalho prático do PlatformIO, desde a criação de um novo projeto até a compilação e execução do código em um ESP32.

### 4.1. Criando seu Primeiro Projeto

A maneira mais fácil de iniciar um projeto é através do assistente gráfico ("Project Wizard") disponível na tela "PlatformIO Home":

1. Inicie o Assistente: Na tela "PlatformIO Home", clique no botão "+ New Project".
2. Configure o Projeto: Uma janela de configuração será exibida. Preencha os seguintes campos:
- Name: Dê um nome descritivo ao seu projeto, por exemplo,
esp32-blink.
- Board: Este é um campo crucial. Comece a digitar o nome da sua placa (ex: "ESP32 Dev Module" ou "DOIT ESP32 DEVKIT V1") e selecione a correspondência exata na lista suspensa. A escolha correta da placa garante que o PlatformIO use as configurações de hardware corretas.
- Framework: Selecione "Arduino". Isso instrui o PlatformIO a utilizar o conjunto de bibliotecas e funções do Arduino Core para o ESP32, proporcionando um ambiente familiar para quem já programou com a IDE do Arduino.
- Location: Você pode manter a localização padrão (geralmente em

### Documentos/PlatformIO/Projects) ou desmarcar a opção "Use

default location" para escolher um diretório personalizado.
3. Finalize a Criação: Clique em "Finish". O PlatformIO levará um momento para baixar as ferramentas necessárias (plataforma, framework, compilador) e criar a estrutura de arquivos do projeto.

### 4.2. Arquitetura do Projeto

Após a criação, o PlatformIO gera uma estrutura de diretórios padronizada e organizada. Essa estrutura não é arbitrária; ela incentiva boas práticas de engenharia de software, como a separação de interesses, tornando o código mais modular, manutenível e escalável desde o início. Os diretórios mais importantes são:

- src/: Este é o diretório principal para o seu código-fonte. O arquivo principal, main.cpp, é criado aqui. O PlatformIO compilará automaticamente todos os arquivos com extensões .c, .cpp ou .ino que estiverem nesta pasta.
- lib/: Destinado a bibliotecas "privadas" ou específicas do projeto. Se você desenvolver um driver ou um módulo de código que não é uma biblioteca pública, pode colocá-lo aqui. Cada biblioteca deve residir em seu próprio subdiretório. O PlatformIO as compila e as vincula ao projeto final automaticamente.
- include/: Um local para arquivos de cabeçalho (.h, .hpp) que precisam ser acessíveis por todo o projeto. Este diretório é adicionado automaticamente ao caminho de busca do compilador, facilitando a organização de interfaces e declarações globais.
- platformio.ini: O arquivo de configuração central é a peça mais importante do projeto. Ele define tudo o que o PlatformIO precisa saber para compilar e carregar seu código.

### 4.3. O Arquivo platformio.ini:

O platformio.ini é o que torna um projeto PlatformIO autossuficiente e portátil. Ele contém todas as definições do ambiente de compilação, garantindo que qualquer pessoa com o PlatformIO instalado possa compilar o projeto exatamente da mesma maneira. O arquivo é organizado em seções, sendo a principal a seção de ambiente, `env`.

A Tabela 1 detalha as diretivas mais comuns e essenciais, servindo como uma referência rápida para a configuração de seus projetos:

Diretiva | Descrição | Exemplo de Uso
platform | Especifica a plataforma de desenvolvimento (família de microcontroladores). | platform = espressif32

Tabela 1: Diretivas comuns para o platformio.ini.

Mais informações podem ser encontradas na documentação oficial: https://docs.platformio.org/en/latest/projectconf/index.html.

### 4.4. O Fluxo de Trabalho na Prática

O PlatformIO integra suas principais ações diretamente na barra de status do VS Code (a barra azul na parte inferior), proporcionando um fluxo de trabalho rápido e eficiente:

- Compilar (Build): O ícone de "check" (✓) aciona o processo de compilação. O PlatformIO compilará todo o código-fonte e as bibliotecas, verificando se há erros de sintaxe. Nenhum código é enviado para a placa nesta etapa.
- Carregar (Upload): O ícone de "seta para a direita" (→) primeiro compila o projeto e, se não houver erros, carrega o firmware compilado para o microcontrolador conectado. Em algumas placas ESP32, pode ser necessário manter o botão "BOOT" pressionado durante o início do upload.
- Monitor Serial: O ícone de "tomada" (🔌) abre um terminal integrado que se conecta à porta serial do dispositivo. Isso é essencial para visualizar a saída
board | O identificador exato da placa de desenvolvimento que está sendo usada. | board = esp32dev
framework | O framework de software a ser utilizado (Arduino, ESP-IDF, etc.). | framework = arduino
lib_deps | Lista as dependências de bibliotecas externas (pelo nome, ID ou URL do Git). | lib_deps = bblanchon/ArduinoJson@^6.19.4
monitor_speed | Define a taxa de transmissão (baud rate) para o Monitor Serial. | monitor_speed = 115200
upload_port | Força o upload para uma porta serial específica (opcional). | upload_port = COM3
monitor_port | Força o Monitor Serial a usar uma porta específica (opcional). | monitor_port = /dev/ttyUSB0
monitor_filters | Adiciona filtros ao Monitor Serial para processar a saída. | monitor_filters = esp32_exception_decoder

de Serial.println() e para depurar o comportamento do programa em tempo real.
- Upload and Monitor: Muitas vezes, a tarefa mais útil é a combinada, que pode ser acessada através do menu de tarefas do PlatformIO. Ela executa o upload e, imediatamente após a conclusão, abre o Monitor Serial, otimizando o ciclo de desenvolvimento e teste.

## 5. Conclusão

Ao longo desta aula, exploramos o PlatformIO não como uma simples ferramenta, mas como um ecossistema completo que redefine o desenvolvimento para sistemas embarcados. Passamos de sua filosofia fundamental de liberdade e interoperabilidade para suas vantagens práticas que impulsionam a produtividade e a qualidade do software.

### 5.1. Recapitulação

O domínio do PlatformIO representa um salto qualitativo nas habilidades de um desenvolvedor embarcado. As vantagens são transformadoras:

- Desenvolvimento Inteligente: Com recursos como autocompletar de código, análise em tempo real e um editor poderoso, o processo de escrita de código se torna mais rápido e menos propenso a erros.
- Gerenciamento Robusto de Dependências: O arquivo platformio.ini garante projetos reprodutíveis e colaborativos, eliminando conflitos de bibliotecas e simplificando o compartilhamento de código.
- Depuração Profissional: A capacidade de realizar depuração on-chip com breakpoints e inspeção de variáveis é uma mudança de paradigma que acelera a identificação e correção de bugs.
- Ecossistema Unificado: A liberdade de trabalhar com centenas de placas e múltiplos frameworks dentro de um único ambiente consistente economiza tempo e reduz a carga cognitiva.

O PlatformIO é a ferramenta que escala com você e seus projetos. Ele é igualmente eficaz para um simples protótipo de "blink" e para um produto comercial complexo, garantindo que você nunca precise abandonar seu ambiente de desenvolvimento à medida que seus desafios crescem.
