GEAR-EST/SEGUIDOR-2026/electronics/design/diagrama_conexao_v2.png

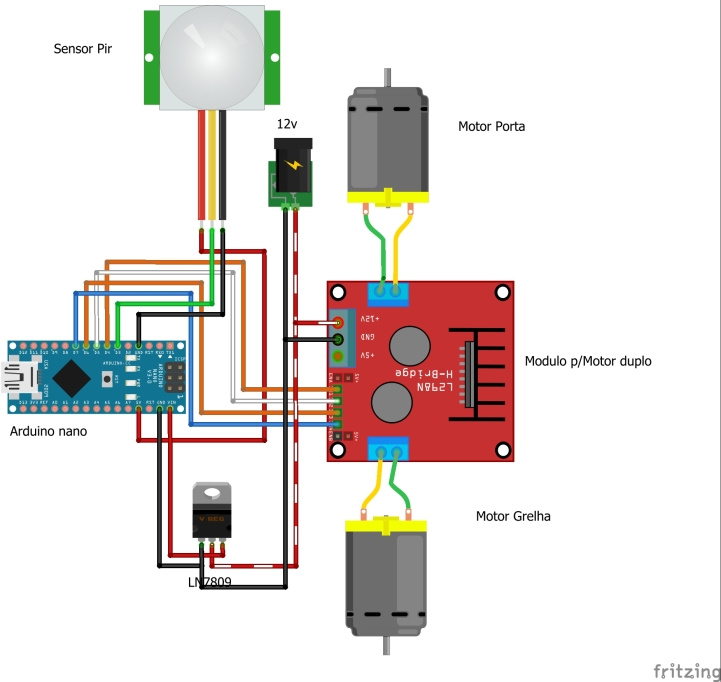
electronics/design/diagrama_conexao_v2.png
