GEAR-EST/SEGUIDOR-2026/electronics/design/pinout_v1.png

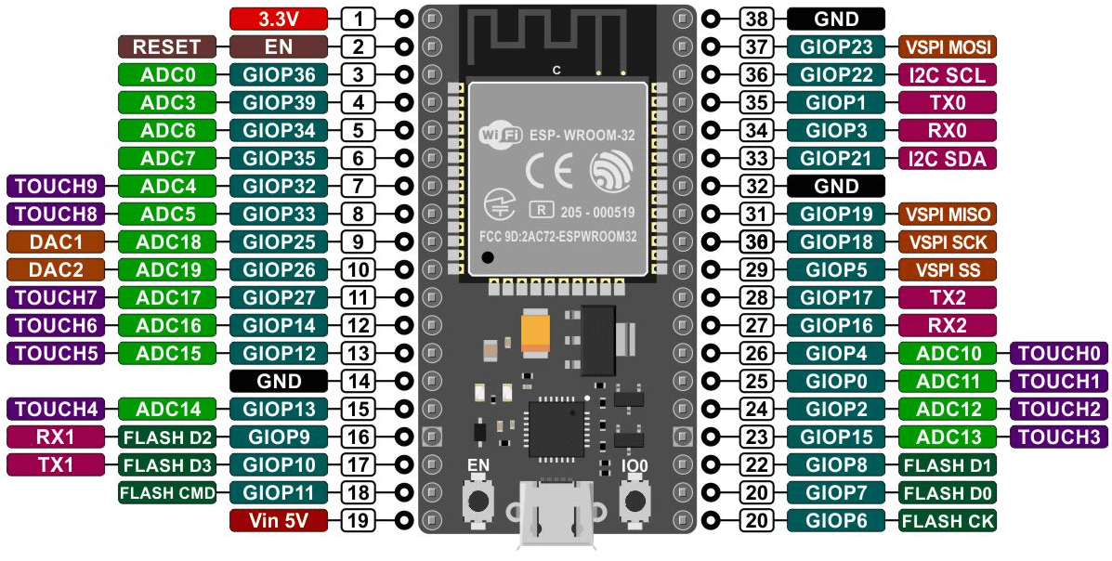
electronics/design/pinout_v1.png
