GEAR-EST/SEGUIDOR-2026/electronics/img/placa_v3.png

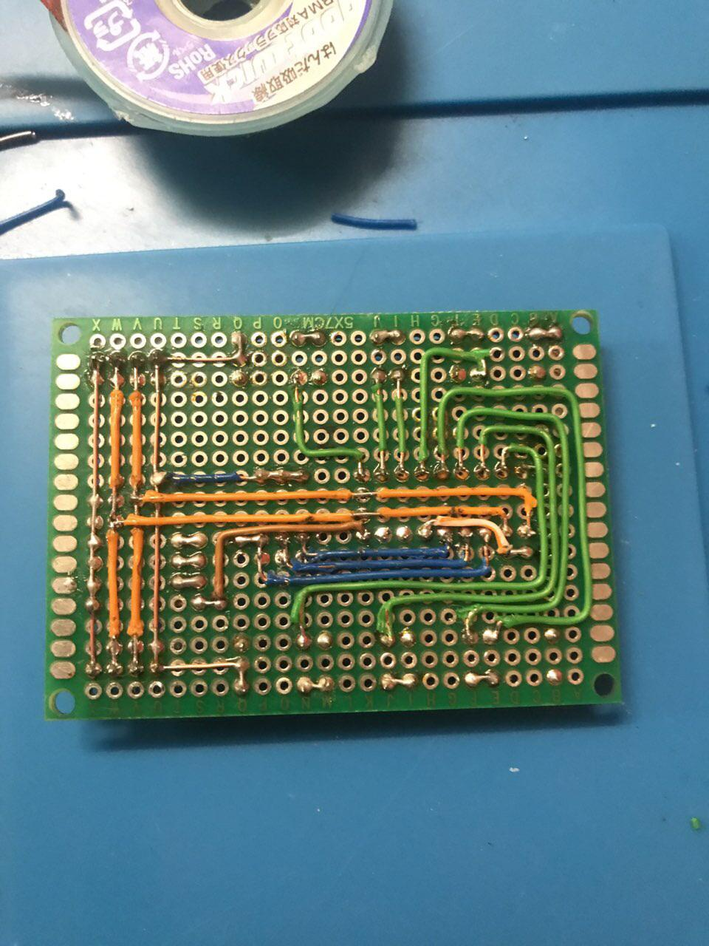
electronics/img/placa_v3.png
