GEAR-EST/SEGUIDOR-2026/electronics/pcb/esquematico_v1.png

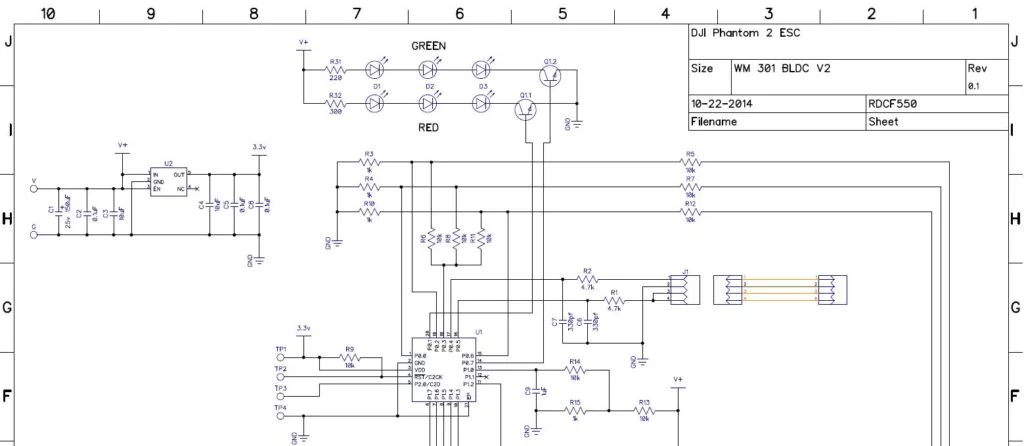
electronics/pcb/esquematico_v1.png
