GEAR-EST/SEGUIDOR-2026/electronics/pcb/Esquemático_PCB_V1.png

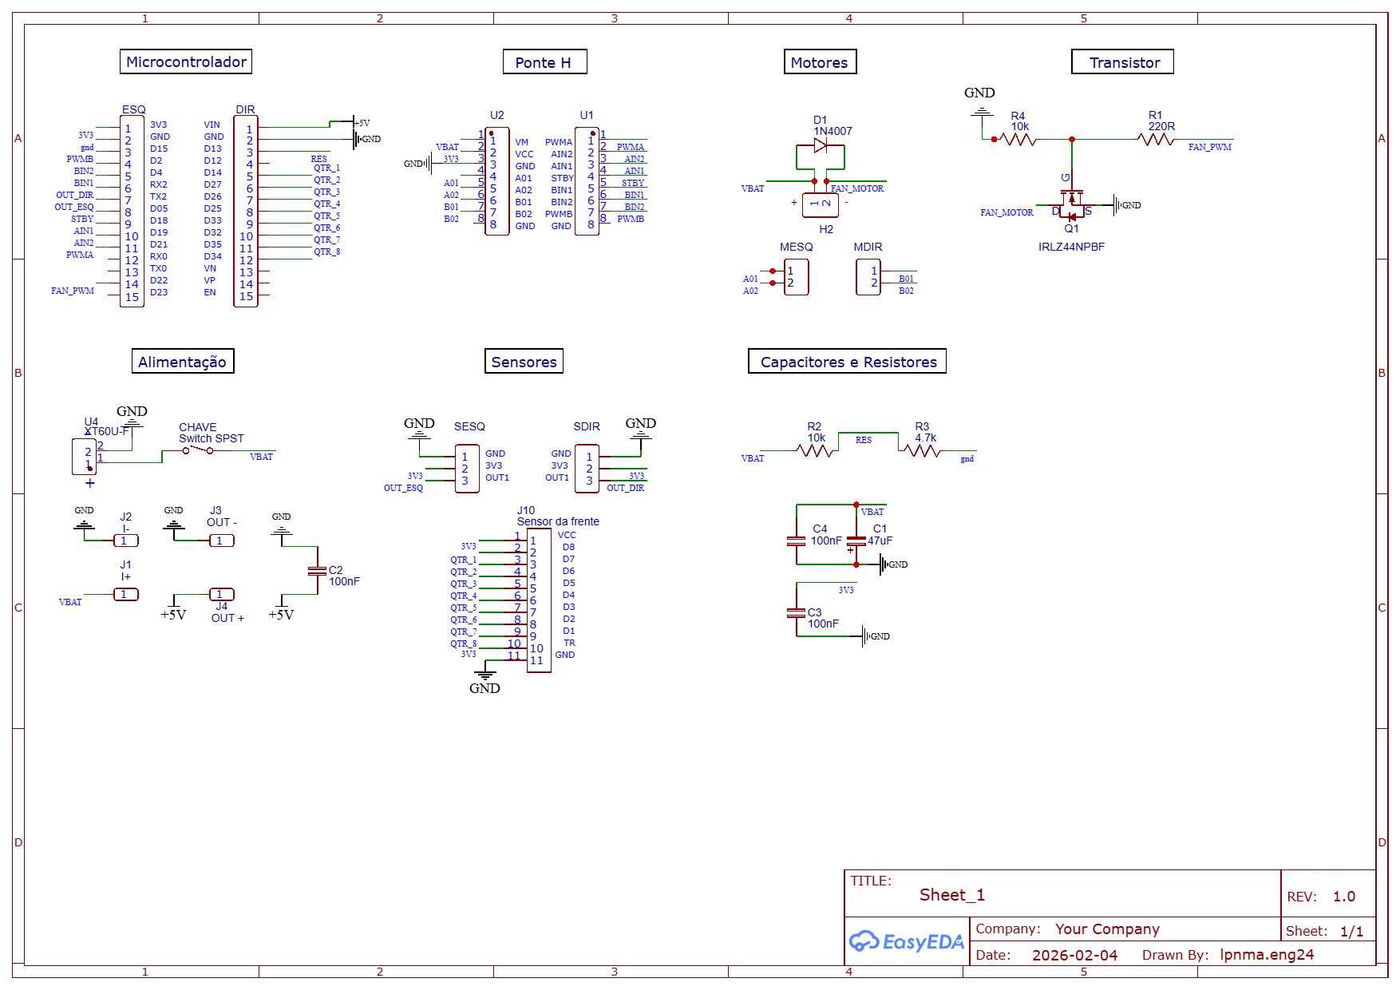
electronics/pcb/Esquemático_PCB_V1.png
