GEAR-EST/SEGUIDOR-2026/electronics/pcb/layout_pcb_v2.png

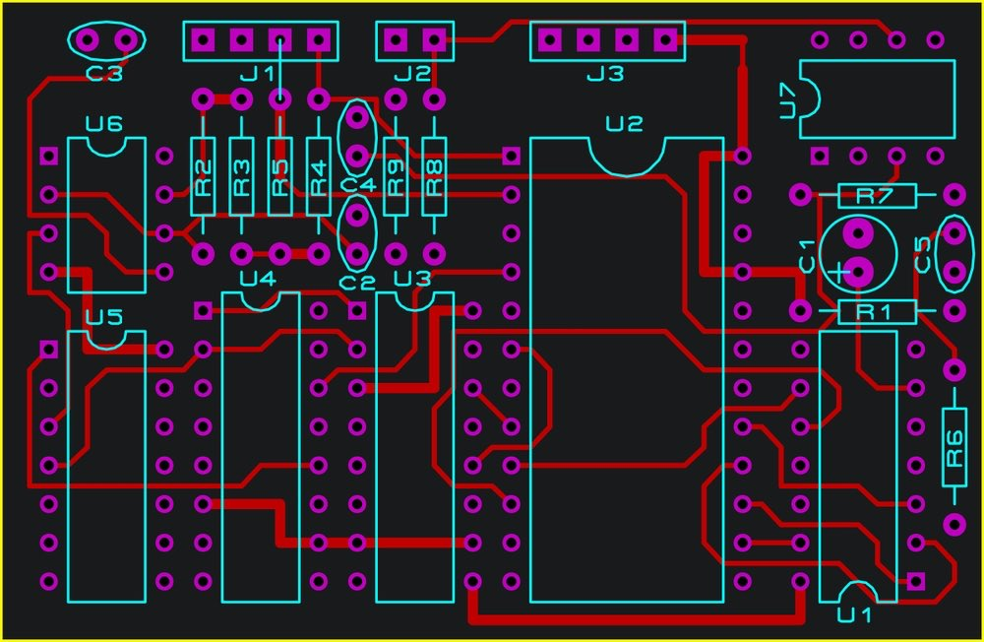
electronics/pcb/layout_pcb_v2.png
