GEAR-EST/SEGUIDOR-2026/mechanics/3d_model/V3/ZeGuia/Render/V2/Baixo 2.jpg

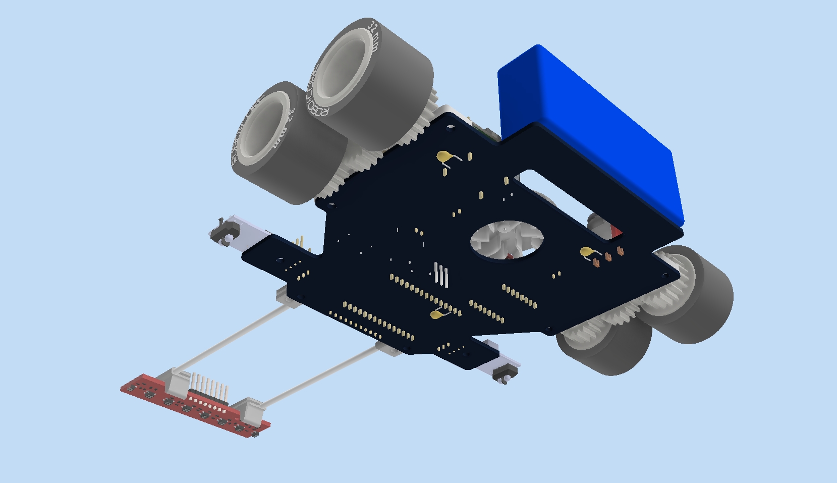
mechanics/3d_model/V3/ZeGuia/Render/V2/Baixo 2.jpg
