GEAR-EST/SEGUIDOR-2026/mechanics/3d_model/V3/ZeGuia/Render/V2/Superior.jpg

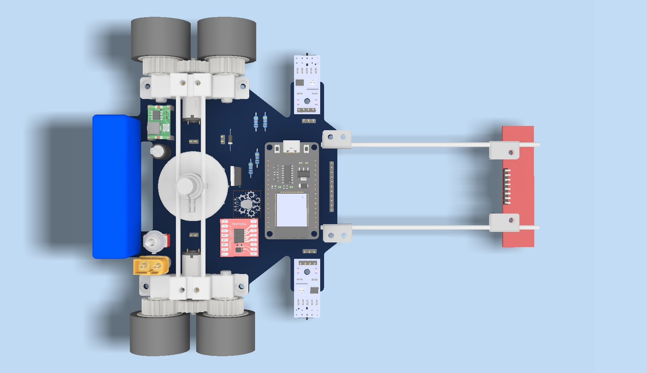
mechanics/3d_model/V3/ZeGuia/Render/V2/Superior.jpg
