GEAR-EST/SEGUIDOR-2026/misc/estudos/lógica de controle/images/Bluetooth - enviado para o computador.jpg

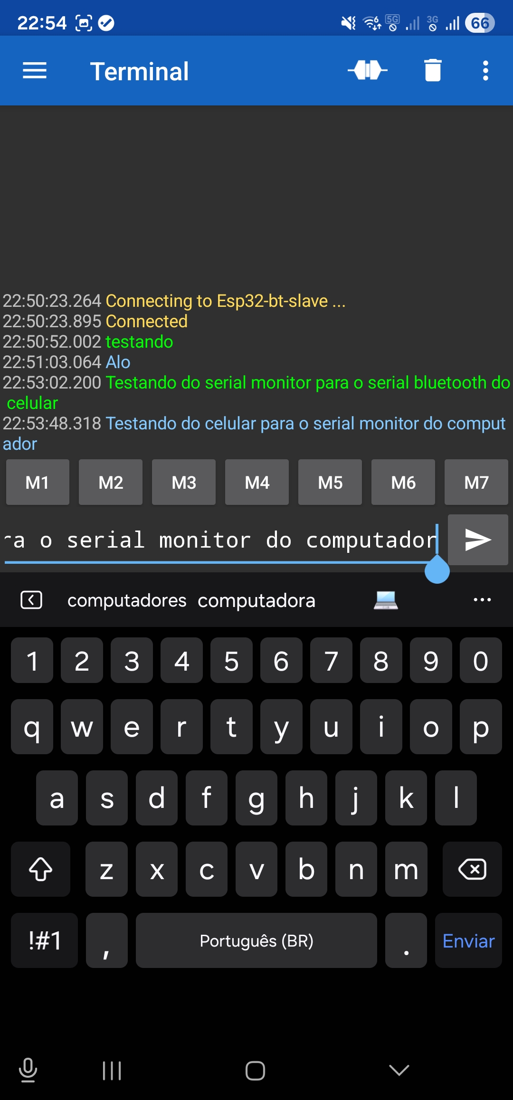
misc/estudos/lógica de controle/images/Bluetooth - enviado para o computador.jpg
