GEAR-EST/SEGUIDOR-2026/misc/estudos/lógica de controle/images/Bluetooth - recebido do computador.jpg

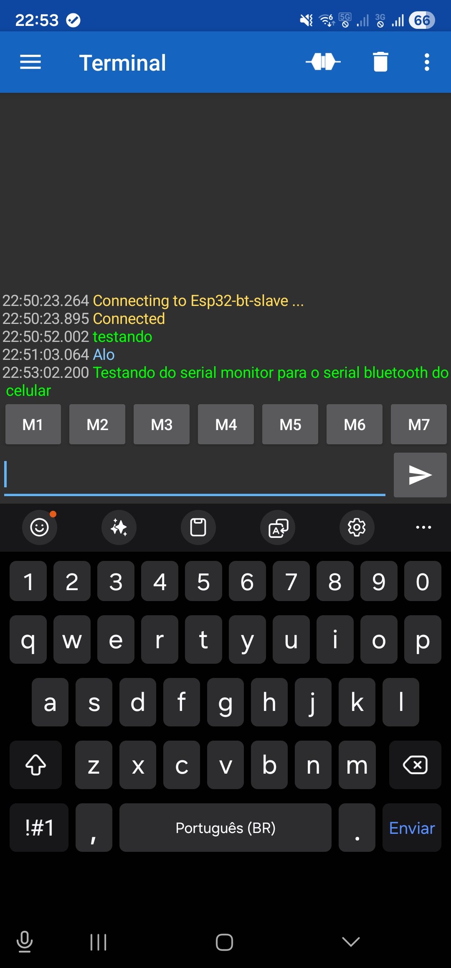
misc/estudos/lógica de controle/images/Bluetooth - recebido do computador.jpg
