GEAR-EST/SEGUIDOR-2026/misc/estudos/lógica de controle/images/Bluetooth - Recebido pelo Celular.png

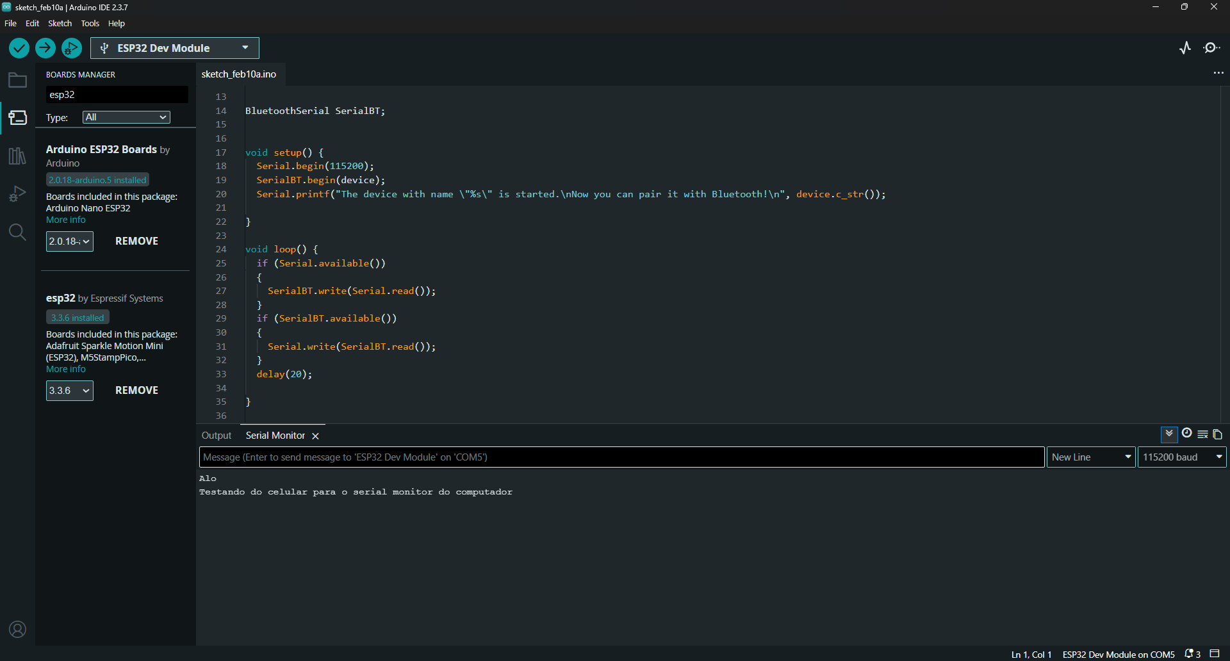
misc/estudos/lógica de controle/images/Bluetooth - Recebido pelo Celular.png
