GEAR-EST/SEGUIDOR-2026/misc/estudos/lógica de controle/images/FSM-Seguidor e Perseguidor de Linha.drawio.png

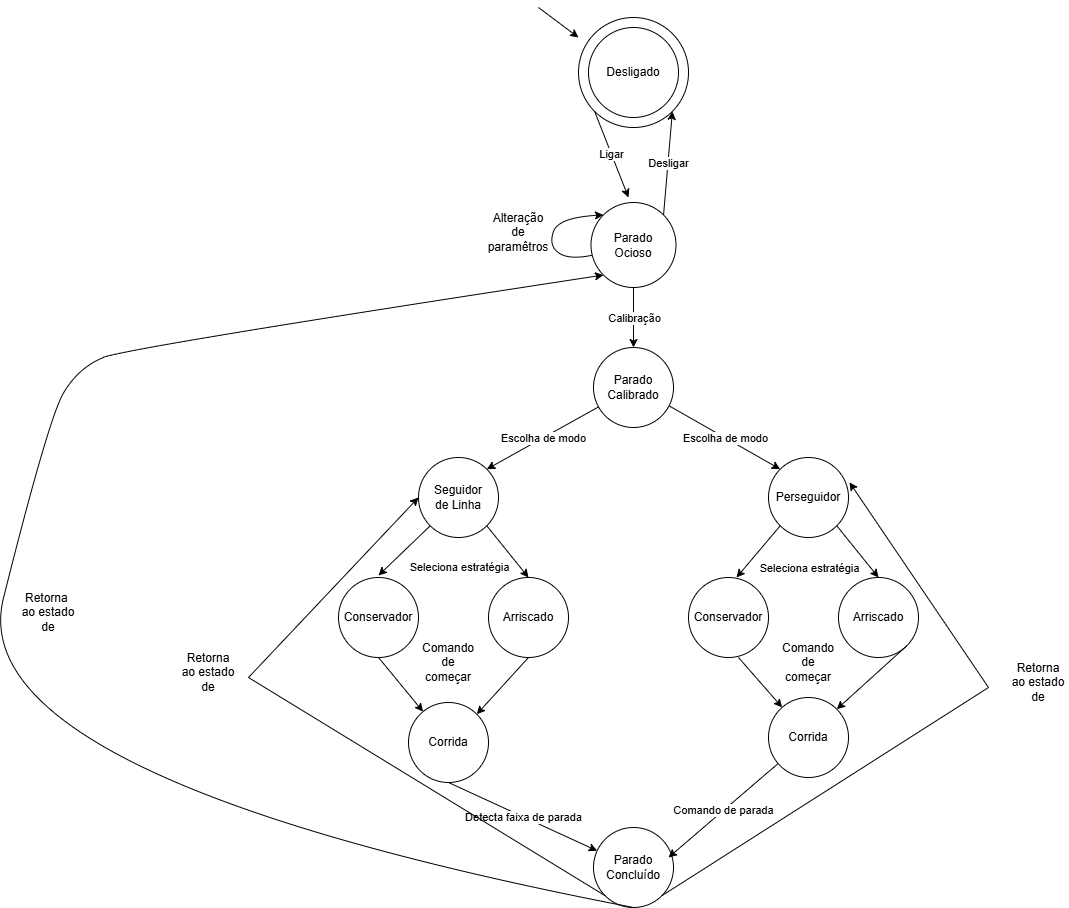
misc/estudos/lógica de controle/images/FSM-Seguidor e Perseguidor de Linha.drawio.png
