GEAR-EST/SEGUIDOR-2026/misc/estudos/media/img/PlacaPCB_Ensacolada.jpeg

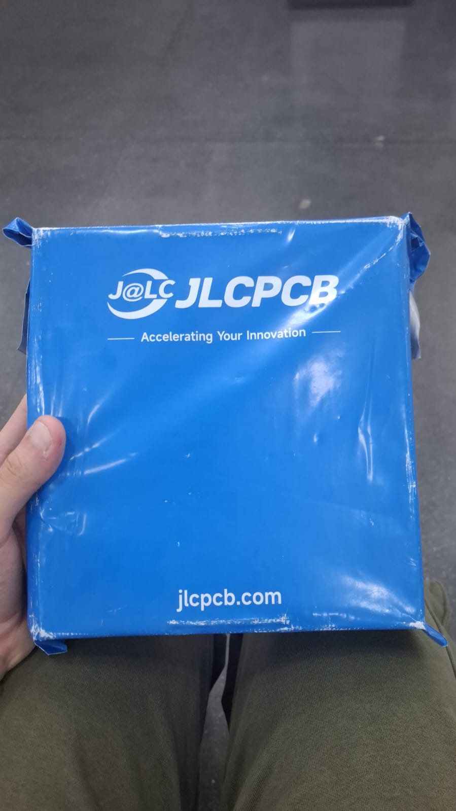
misc/estudos/media/img/PlacaPCB_Ensacolada.jpeg
