GEAR-EST/SEGUIDOR-2026/misc/estudos/media/img/Visão_3d_V1.png

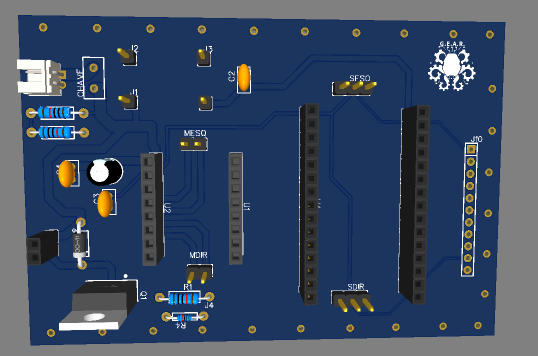
misc/estudos/media/img/Visão_3d_V1.png
