GEAR-EST/SEGUIDOR-2026/misc/estudos/media/img/Visão_3d_V2.png

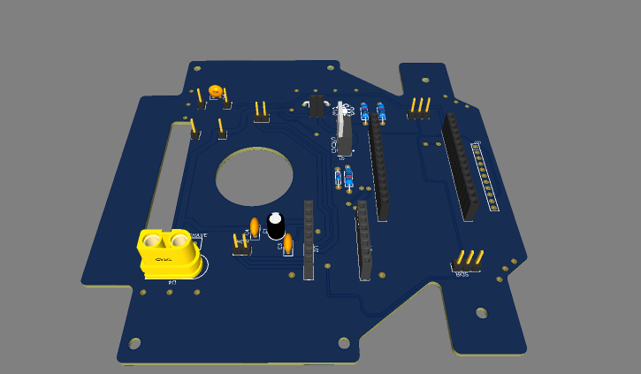
misc/estudos/media/img/Visão_3d_V2.png
