GEAR-EST/SEGUIDOR-2026/mechanics/3d_model/V3/ZeGuia/3D/Imprimir/Sup_haste_sensor.3mf

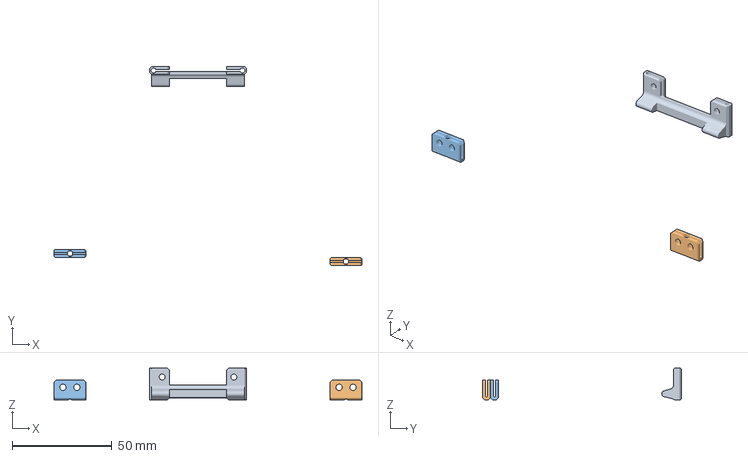
[picture p147: CAD file, 2026-07-15]
mechanics/3d_model/V3/ZeGuia/3D/Imprimir/Sup_haste_sensor.3mf
154.6 x 100.0 x 16.0 mm
Sup_haste_sensor.stl
Sup_haste_corpo.stl x 2
