GEAR-EST/SEGUIDOR-2026/mechanics/stl_file/PCB.stl

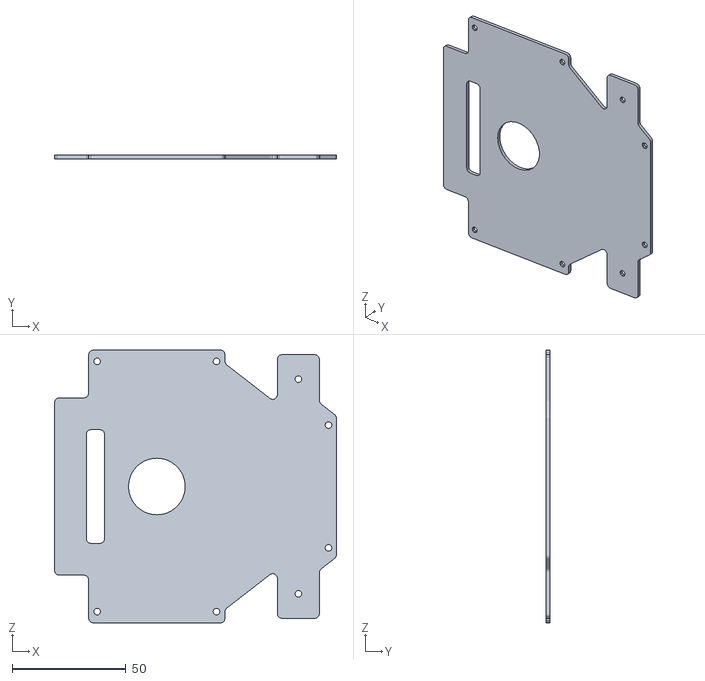
[picture p148: CAD file, 2026-07-15]
mechanics/stl_file/PCB.stl
124.0 x 1.60 x 120.0
