GEAR-EST/SEGUIDOR-2026/mechanics/stl_file/Sup_haste_sensor.stl

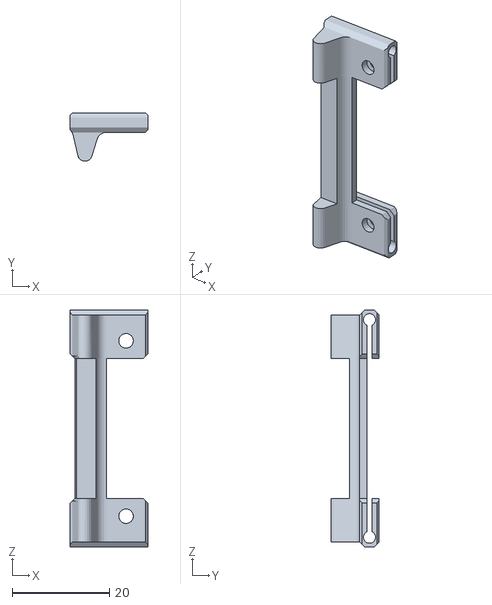
[picture p149: CAD file, 2026-07-15]
mechanics/stl_file/Sup_haste_sensor.stl
16.0 x 9.94 x 48.6
