GEAR-EST/SEGUIDOR-2026/mechanics/3d_model/V3/ZeGuia/3D/Imprimir/Sup_motor_coreless.stl

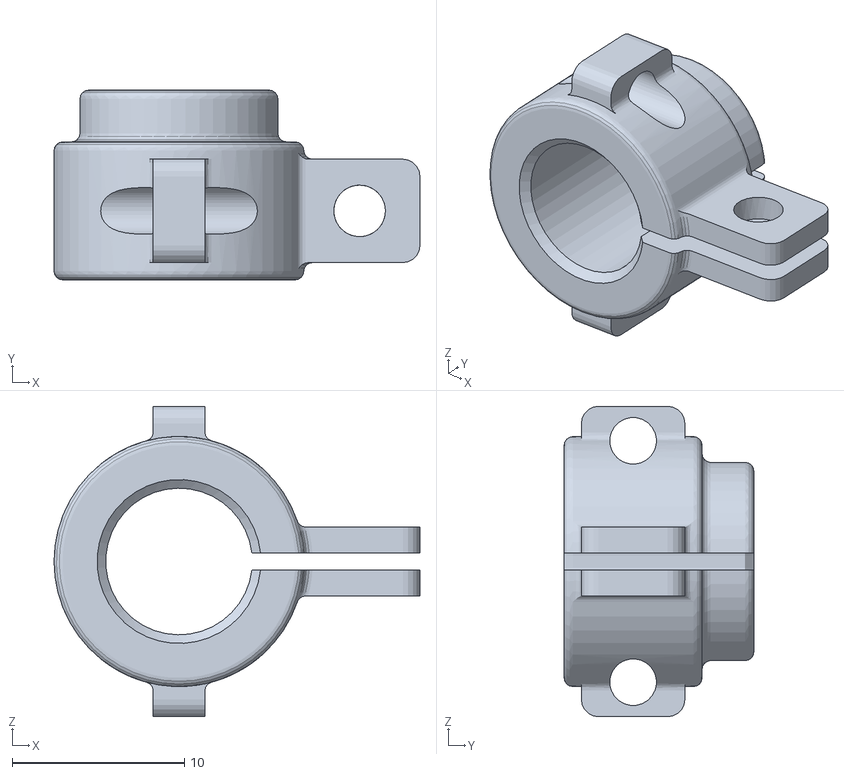
[picture p150: CAD file, 2026-07-15]
mechanics/3d_model/V3/ZeGuia/3D/Imprimir/Sup_motor_coreless.stl
21.2 x 11.0 x 18.0
