GEAR-EST/SEGUIDOR-2026/mechanics/3d_model/V3/ZeGuia/3D/Imprimir/Helice.3mf

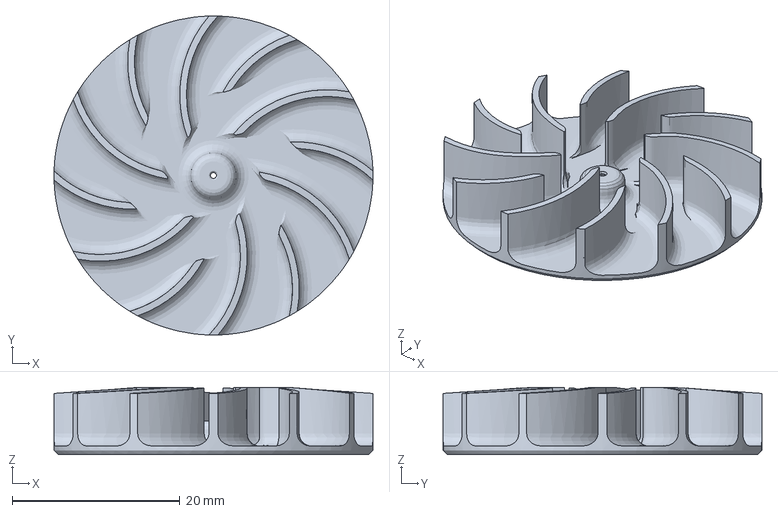
[picture p151: CAD file, 2026-07-15]
mechanics/3d_model/V3/ZeGuia/3D/Imprimir/Helice.3mf
38.0 x 38.0 x 8.00 mm
