GEAR-EST/SEGUIDOR-2026/mechanics/3d_model/V3/ZeGuia/3D/Imprimir/Sup_haste_corpo.stl

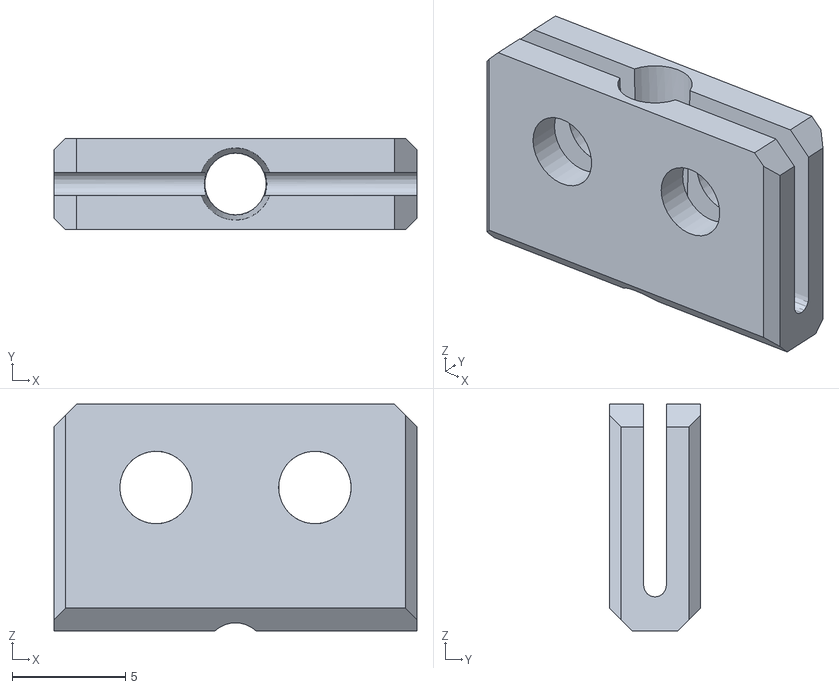
[picture p152: CAD file, 2026-07-15]
mechanics/3d_model/V3/ZeGuia/3D/Imprimir/Sup_haste_corpo.stl
16.0 x 4.00 x 10.0
