GEAR-EST/SEGUIDOR-2026/mechanics/3d_model/V3/ZeGuia/3D/Imprimir/Suporte Motor e Rodas.stl

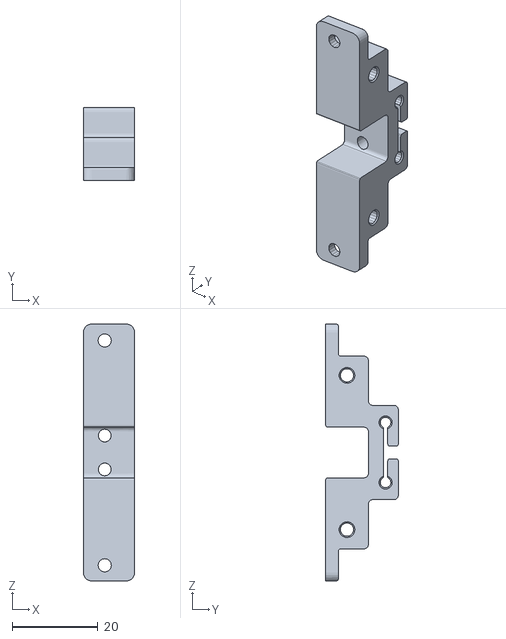
[picture p153: CAD file, 2026-03-25]
mechanics/3d_model/V3/ZeGuia/3D/Imprimir/Suporte Motor e Rodas.stl
12.0 x 17.0 x 60.0
