GEAR-EST/SEGUIDOR-2026/mechanics/3d_model/V3/ZeGuia/3D/Imprimir/Sup_haste_sensor_D.stl

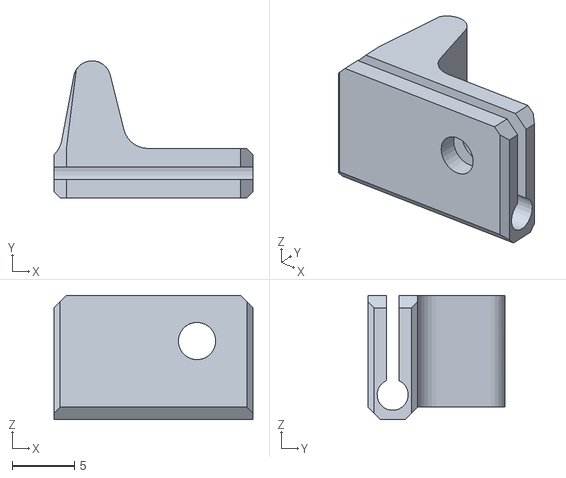
[picture p154: CAD file, 2026-03-25]
mechanics/3d_model/V3/ZeGuia/3D/Imprimir/Sup_haste_sensor_D.stl
16.0 x 11.0 x 10.0
