GEAR-EST/SEGUIDOR-2026/mechanics/3d_model/V3/ZeGuia/3D/Imprimir/Engrenagens rodas.stl

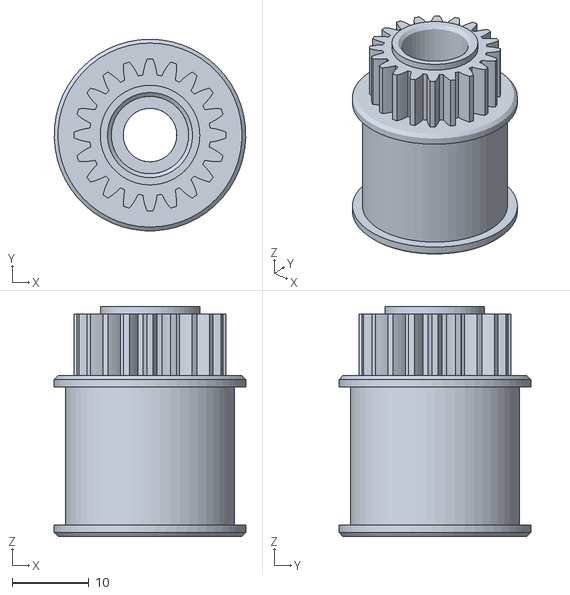
[picture p155: CAD file, 2026-03-25]
mechanics/3d_model/V3/ZeGuia/3D/Imprimir/Engrenagens rodas.stl
25.0 x 25.0 x 30.0
