GEAR-EST/SEGUIDOR-2026/mechanics/3d_model/V3/ZeGuia/3D/Imprimir/Engrenagens motor.3mf

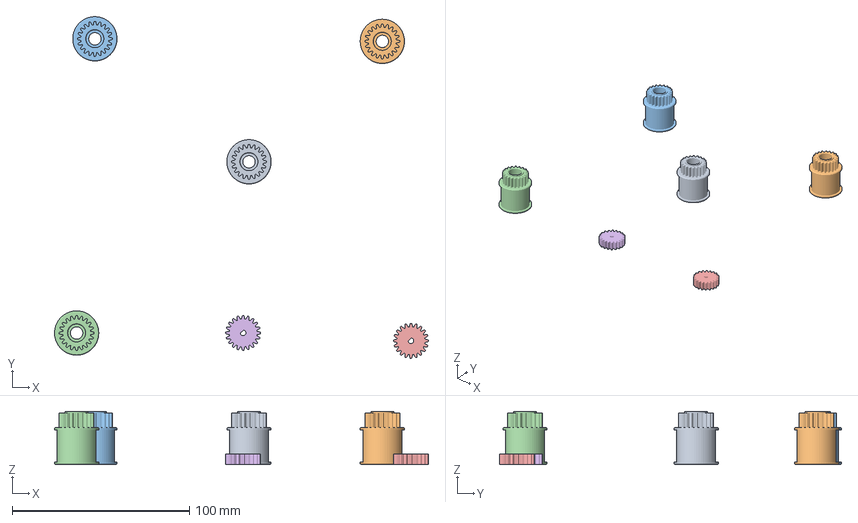
[picture p156: CAD file, 2026-03-25]
mechanics/3d_model/V3/ZeGuia/3D/Imprimir/Engrenagens motor.3mf
211.0 x 192.8 x 30.0 mm
Engrenagens rodas.stl x 4
Engrenagens motor.stl x 2
