GEAR-EST/SEGUIDOR-2026/mechanics/3d_model/V3/ZeGuia/3D/Imprimir/Suporte Sensor.stl

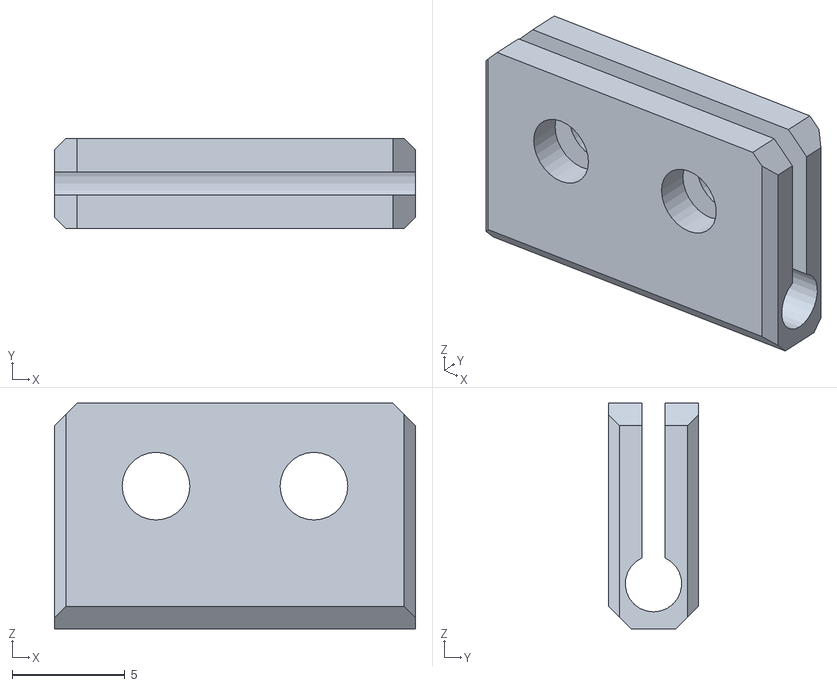
[picture p157: CAD file, 2026-03-25]
mechanics/3d_model/V3/ZeGuia/3D/Imprimir/Suporte Sensor.stl
16.0 x 4.00 x 10.0
