GEAR-EST/SEGUIDOR-2026/mechanics/3d_model/V1/ZeGuia/3D/Engrenagem reta Roda.stl

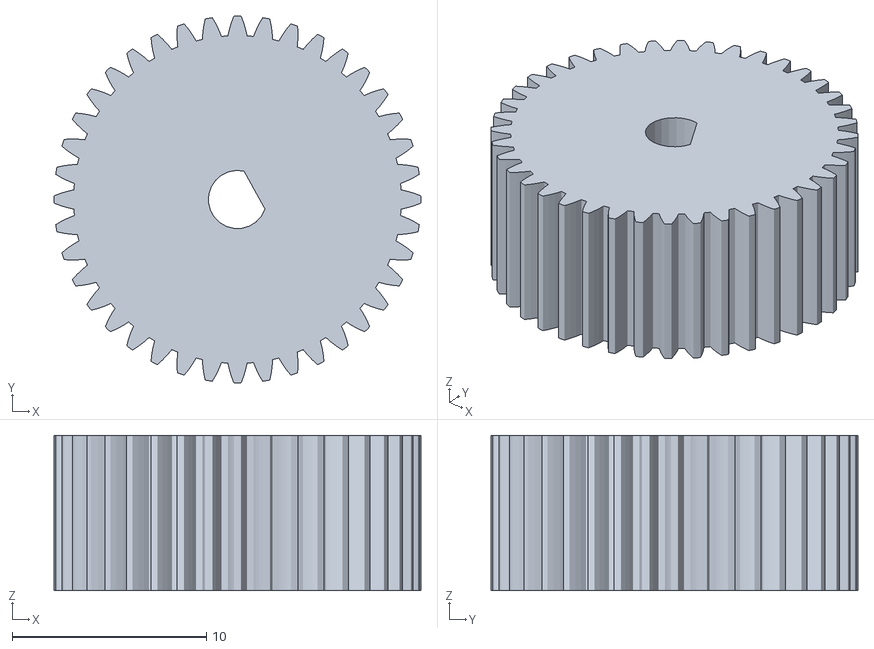
[picture p158: CAD file, 2026-03-25, an earlier design]
mechanics/3d_model/V1/ZeGuia/3D/Engrenagem reta Roda.stl
18.9 x 18.9 x 8.00
