GEAR-EST/SEGUIDOR-2026/(list of files, cad)

Other CAD files:
mechanics/3d_model/V3/ZeGuia/Pistas/Pista de Teste V1/Pista_Teste_V1.dwg
mechanics/3d_model/V3/ZeGuia/Pistas/V2/Pista_V2.dwg
mechanics/3d_model/V3/ZeGuia/Placa/Dimensoes Placa.dwg
mechanics/3d_model/V3/ZeGuia/3D/Imprimir/Sup_haste_sensor_E.stl
mechanics/3d_model/V1/ZeGuia/OldVersions/Dimensoes Placa.0001.dwg
mechanics/3d_model/V1/ZeGuia/3D/Engrenagem reta Motor.stl
mechanics/3d_model/V1/ZeGuia/3D/Suporte.stl
mechanics/3d_model/V1/ZeGuia/3D/Suporte/Haste sensor/OldVersions/Sup_haste_corpo.0001.ipt
mechanics/3d_model/V1/ZeGuia/3D/Suporte/Haste sensor/OldVersions/Sup_haste_sensor_D.0001.ipt
mechanics/3d_model/V1/ZeGuia/3D/Suporte/Haste sensor/OldVersions/Sup_haste_sensor_E.0001.ipt
mechanics/3d_model/V1/ZeGuia/3D/Suporte/OldVersions/HASTE_FIBRA.0001.ipt
mechanics/3d_model/V1/ZeGuia/Componentes/Controlador/esp32/OldVersions/esp32_30pin.0003.iam
mechanics/3d_model/V1/ZeGuia/Componentes/Ponte H/TB6612FNG/OldVersions/TB6612FNG.0001.iam
mechanics/3d_model/V1/ZeGuia/Montagem/4x2/Base/4x2/Design Accelerator/OldVersions/Engrenagem reta17.0003.ipt
mechanics/3d_model/V1/ZeGuia/Montagem/4x2/Base/OldVersions/4x2.0009.iam
mechanics/3d_model/V1/ZeGuia/Montagem/4x2/OldVersions/Suporte.0006.ipt
mechanics/3d_model/V1/ZeGuia/Montagem/Turbina/Helice/OldVersions/Helice.0001.ipt
mechanics/3d_model/V1/ZeGuia/Montagem/Turbina/OldVersions/Turbina.0001.iam
mechanics/3d_model/V1/ZeGuia/OldVersions/Montagem Ze Guia.0010.iam
mechanics/3d_model/V1/ZeGuia/OldVersions/Montagem Ze Guia.0012.iam
mechanics/3d_model/V1/ZeGuia/Placa/OldVersions/PCB.0022.ipt
mechanics/3d_model/V1/ZeGuia/Roda/OldVersions/Roda.0002.iam
mechanics/3d_model/V1/ZeGuia/Sensores/TCRT5000/OldVersions/TCRT5000.0001.iam
mechanics/3d_model/V2/ZeGuia/3D/Suporte/Haste/Sup_haste_corpo.ipt
mechanics/3d_model/V2/ZeGuia/3D/Suporte/Haste/Sup_haste_sensor_D.ipt
mechanics/3d_model/V2/ZeGuia/3D/Suporte/Haste/Sup_haste_sensor_E.ipt
mechanics/3d_model/V2/ZeGuia/3D/Suporte/Haste/Sup_motor_coreless.ipt
mechanics/3d_model/V3/ZeGuia/3D/Imprimir/Engrenagens motor.stl
mechanics/3d_model/V3/ZeGuia/3D/Imprimir/Helice.stl
mechanics/3d_model/V3/ZeGuia/3D/Suporte/HASTE_FIBRA.ipt
mechanics/3d_model/V3/ZeGuia/3D/Suporte/Haste sensor/Sup_haste_corpo.ipt
mechanics/3d_model/V3/ZeGuia/3D/Suporte/Haste sensor/Sup_haste_sensor.iam
mechanics/3d_model/V3/ZeGuia/3D/Suporte/Haste sensor/Sup_haste_sensor_D.ipt
mechanics/3d_model/V3/ZeGuia/3D/Suporte/Haste sensor/Sup_haste_sensor_E.ipt
mechanics/3d_model/V3/ZeGuia/3D/Suporte/Haste sensor/Sup_motor_coreless.ipt
mechanics/3d_model/V3/ZeGuia/Bateria/Bateria.ipt
mechanics/3d_model/V3/ZeGuia/Bateria/Conector XT60/XT60.iam
mechanics/3d_model/V3/ZeGuia/Bateria/Conector XT60/parts/12GA.ipt
mechanics/3d_model/V3/ZeGuia/Bateria/Conector XT60/parts/14GA.ipt
mechanics/3d_model/V3/ZeGuia/Bateria/Conector XT60/parts/Contact.ipt
mechanics/3d_model/V3/ZeGuia/Bateria/Conector XT60/parts/Plug.ipt
mechanics/3d_model/V3/ZeGuia/Bateria/Conector XT60/parts/Wire Cover.ipt
mechanics/3d_model/V3/ZeGuia/Carrinho + Pista.iam
mechanics/3d_model/V3/ZeGuia/Componentes/Controlador/esp32/esp32_30pin.iam
mechanics/3d_model/V3/ZeGuia/Componentes/Controlador/esp32/parts/0603 cap.ipt
mechanics/3d_model/V3/ZeGuia/Componentes/Controlador/esp32/parts/0603 resistor.ipt
mechanics/3d_model/V3/ZeGuia/Componentes/Controlador/esp32/parts/1.ipt
mechanics/3d_model/V3/ZeGuia/Componentes/Controlador/esp32/parts/2.ipt
mechanics/3d_model/V3/ZeGuia/Componentes/Controlador/esp32/parts/3.ipt
mechanics/3d_model/V3/ZeGuia/Componentes/Controlador/esp32/parts/4.ipt
mechanics/3d_model/V3/ZeGuia/Componentes/Controlador/esp32/parts/5.ipt
mechanics/3d_model/V3/ZeGuia/Componentes/Controlador/esp32/parts/6.ipt
mechanics/3d_model/V3/ZeGuia/Componentes/Controlador/esp32/parts/61301511121 (1).iam
mechanics/3d_model/V3/ZeGuia/Componentes/Controlador/esp32/parts/61301511121.ipt
mechanics/3d_model/V3/ZeGuia/Componentes/Controlador/esp32/parts/6130xx11121_PIN.ipt
mechanics/3d_model/V3/ZeGuia/Componentes/Controlador/esp32/parts/7.ipt
mechanics/3d_model/V3/ZeGuia/Componentes/Controlador/esp32/parts/7508963920.ipt
mechanics/3d_model/V3/ZeGuia/Componentes/Controlador/esp32/parts/7508964400.iam
mechanics/3d_model/V3/ZeGuia/Componentes/Controlador/esp32/parts/8.ipt
mechanics/3d_model/V3/ZeGuia/Componentes/Controlador/esp32/parts/9.ipt
mechanics/3d_model/V3/ZeGuia/Componentes/Controlador/esp32/parts/A1.iam
mechanics/3d_model/V3/ZeGuia/Componentes/Controlador/esp32/parts/Board.iam
mechanics/3d_model/V3/ZeGuia/Componentes/Controlador/esp32/parts/Body.iam
mechanics/3d_model/V3/ZeGuia/Componentes/Controlador/esp32/parts/C&K - KMR7.ipt
mechanics/3d_model/V3/ZeGuia/Componentes/Controlador/esp32/parts/Conn_Molex_2171790001_eec.iam
mechanics/3d_model/V3/ZeGuia/Componentes/Controlador/esp32/parts/Designator10.iam
mechanics/3d_model/V3/ZeGuia/Componentes/Controlador/esp32/parts/Designator11.iam
mechanics/3d_model/V3/ZeGuia/Componentes/Controlador/esp32/parts/Designator12 (1).iam
mechanics/3d_model/V3/ZeGuia/Componentes/Controlador/esp32/parts/Designator12.iam
mechanics/3d_model/V3/ZeGuia/Componentes/Controlador/esp32/parts/Designator13.iam
mechanics/3d_model/V3/ZeGuia/Componentes/Controlador/esp32/parts/Designator14 (1).iam
mechanics/3d_model/V3/ZeGuia/Componentes/Controlador/esp32/parts/Designator14.iam
mechanics/3d_model/V3/ZeGuia/Componentes/Controlador/esp32/parts/Designator15.iam
mechanics/3d_model/V3/ZeGuia/Componentes/Controlador/esp32/parts/Designator15_1.iam
mechanics/3d_model/V3/ZeGuia/Componentes/Controlador/esp32/parts/Designator16.iam
mechanics/3d_model/V3/ZeGuia/Componentes/Controlador/esp32/parts/Designator16_1.iam
mechanics/3d_model/V3/ZeGuia/Componentes/Controlador/esp32/parts/Designator17.iam
mechanics/3d_model/V3/ZeGuia/Componentes/Controlador/esp32/parts/Designator18 (1).iam
mechanics/3d_model/V3/ZeGuia/Componentes/Controlador/esp32/parts/Designator18.iam
mechanics/3d_model/V3/ZeGuia/Componentes/Controlador/esp32/parts/Designator19.iam
mechanics/3d_model/V3/ZeGuia/Componentes/Controlador/esp32/parts/Designator20.iam
mechanics/3d_model/V3/ZeGuia/Componentes/Controlador/esp32/parts/Designator6.iam
mechanics/3d_model/V3/ZeGuia/Componentes/Controlador/esp32/parts/Designator8.iam
mechanics/3d_model/V3/ZeGuia/Componentes/Controlador/esp32/parts/Designator9 (1).iam
mechanics/3d_model/V3/ZeGuia/Componentes/Controlador/esp32/parts/Designator9.iam
mechanics/3d_model/V3/ZeGuia/Componentes/Controlador/esp32/parts/Free-Models.iam
mechanics/3d_model/V3/ZeGuia/Componentes/Controlador/esp32/parts/LED 0603 Base GREEN.ipt
mechanics/3d_model/V3/ZeGuia/Componentes/Controlador/esp32/parts/LED 0603 Lens GREEN.ipt
mechanics/3d_model/V3/ZeGuia/Componentes/Controlador/esp32/parts/Leader.ipt
mechanics/3d_model/V3/ZeGuia/Componentes/Controlador/esp32/parts/Molex.ipt
mechanics/3d_model/V3/ZeGuia/Componentes/Controlador/esp32/parts/Notch.ipt
mechanics/3d_model/V3/ZeGuia/Componentes/Controlador/esp32/parts/Open CASCADE STEP translator 6.8 6.1.ipt
mechanics/3d_model/V3/ZeGuia/Componentes/Controlador/esp32/parts/Open CASCADE STEP translator 6.8 6.2.1.ipt
mechanics/3d_model/V3/ZeGuia/Componentes/Controlador/esp32/parts/Open CASCADE STEP translator 7.5 114.1.1.ipt
mechanics/3d_model/V3/ZeGuia/Componentes/Controlador/esp32/parts/SMA.ipt
mechanics/3d_model/V3/ZeGuia/Componentes/Controlador/esp32/parts/SOT-223.ipt
mechanics/3d_model/V3/ZeGuia/Componentes/Controlador/esp32/parts/SOT-23-3.ipt
mechanics/3d_model/V3/ZeGuia/Componentes/Eletronica/Capacitor/Ceramico/CAP_DISC_4x3_YL.ipt
mechanics/3d_model/V3/ZeGuia/Componentes/Eletronica/Capacitor/Eletrolitico/CAP_RAD_D16x25_POL_BK.ipt
mechanics/3d_model/V3/ZeGuia/Componentes/Eletronica/Capacitor/Eletrolitico/CAP_RAD_D8x15_POL_BK.ipt
mechanics/3d_model/V3/ZeGuia/Componentes/Eletronica/Diodo/Diodo 1N4007.ipt
mechanics/3d_model/V3/ZeGuia/Componentes/Eletronica/MOSFET/irlz44n.ipt
mechanics/3d_model/V3/ZeGuia/Componentes/Eletronica/Resistor/RES-0.25W-H-MF.ipt
mechanics/3d_model/V3/ZeGuia/Componentes/Eletronica/Resistor/RES-0.5W-H-MF.ipt
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
