GEAR-EST/SEGUIDOR-2026/mechanics/img/PDF pistas/Pista Teste V1.pdf

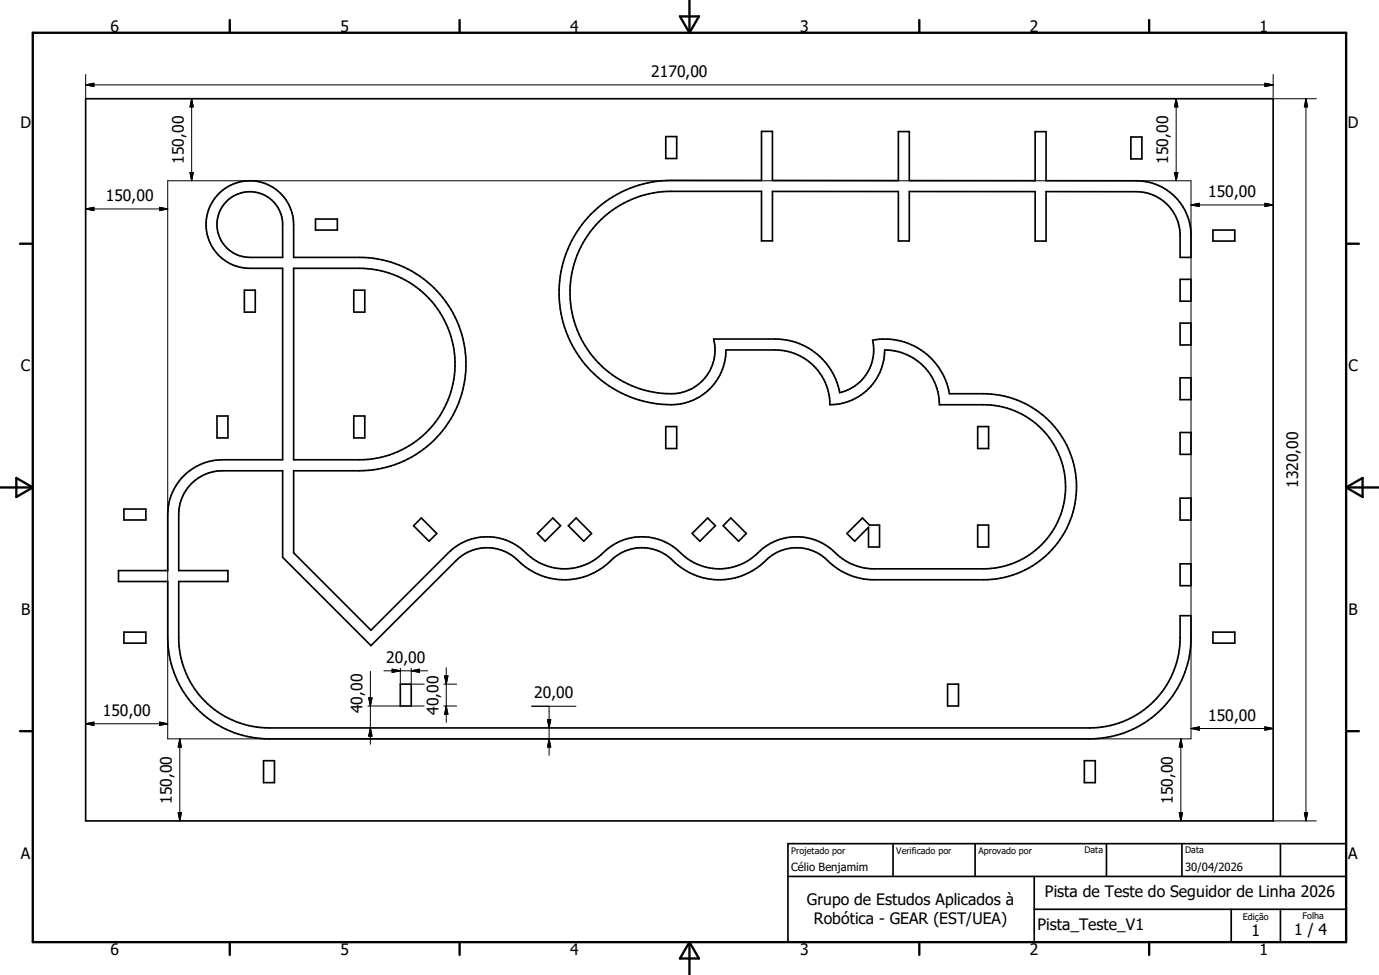
[picture p159: page 1]

Projetado por Célio Benjamim | Verificado por | Aprovado por Data | Data 30/04/2026

Grupo de Estudos Aplicados à Robótica - GEAR (EST/UEA) | Pista de Teste do Seguidor de Linha 2026

Pista_Teste_V1 | Edição | Folha 1 / 4

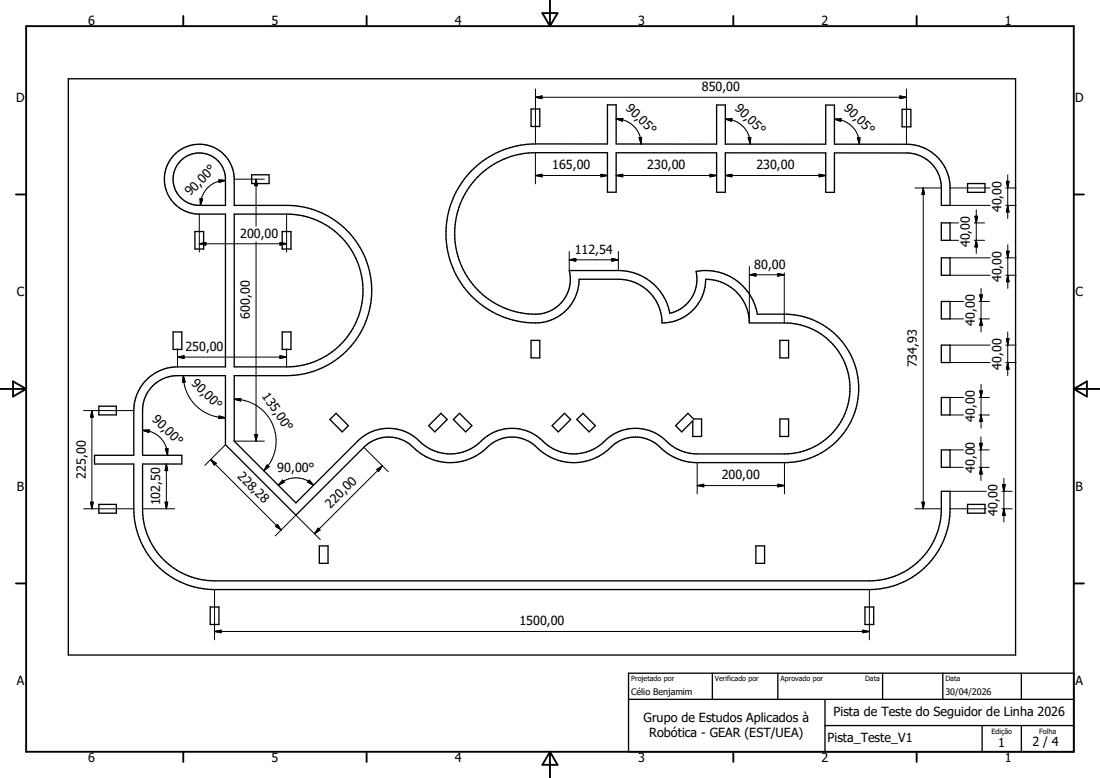
[picture p160: page 2]
1500,00 ²²⁵,00

Projetado por Célio Benjamim | Verificado por | Aprovado por Data | Data 30/04/2026

Pista de Teste do Seguidor de Linha 2026

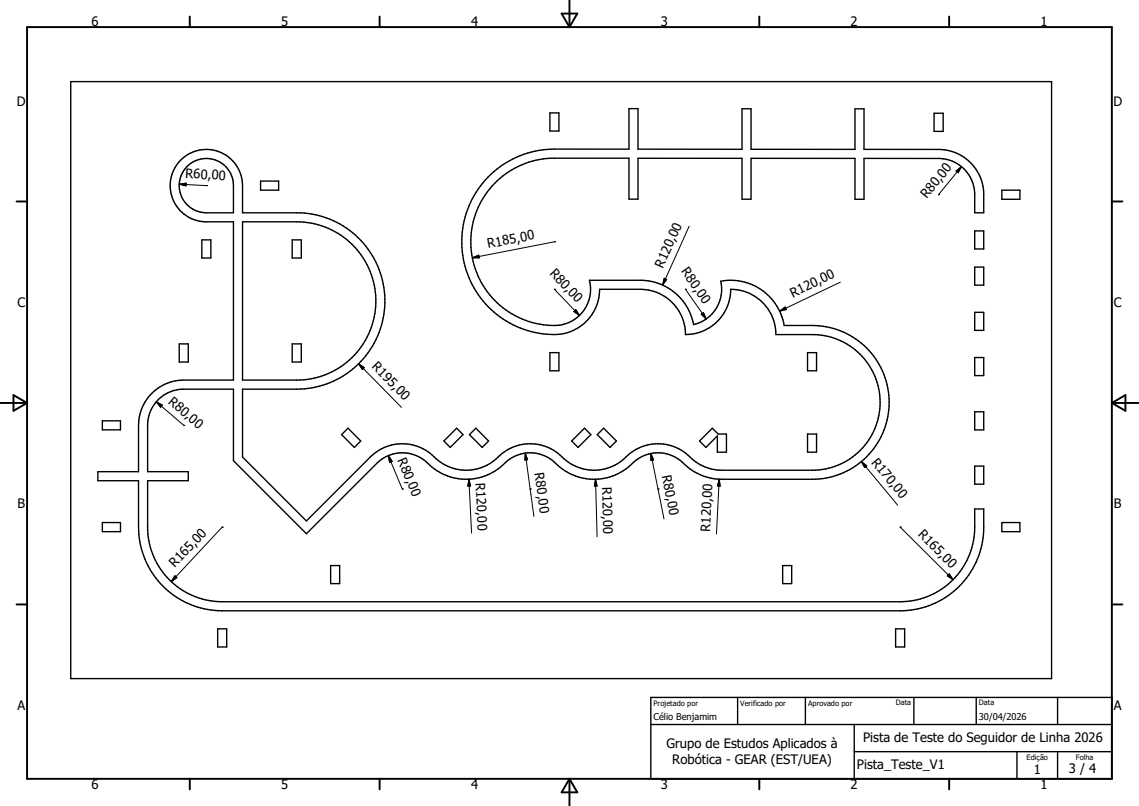
[picture p161: page 3]

Projetado por Célio Benjamim | Verificado por | Aprovado por Data | Data 30/04/2026

Pista de Teste do Seguidor de Linha 2026

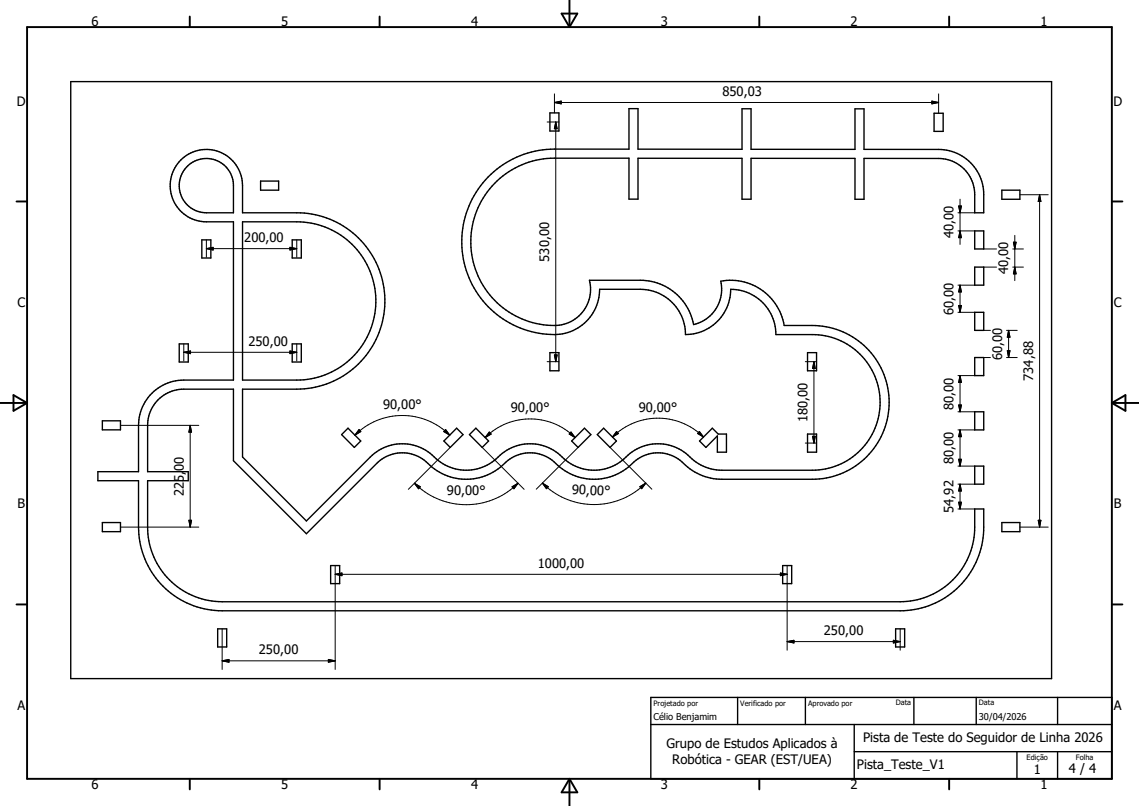
[picture p162: page 4]
250,00 ²²⁵,00

Projetado por Célio Benjamim | Verificado por | Aprovado por Data | Data 30/04/2026

Pista de Teste do Seguidor de Linha 2026
