GEAR-EST/SEGUIDOR-2026/mechanics/img/PDF pistas/Pista_V2.pdf

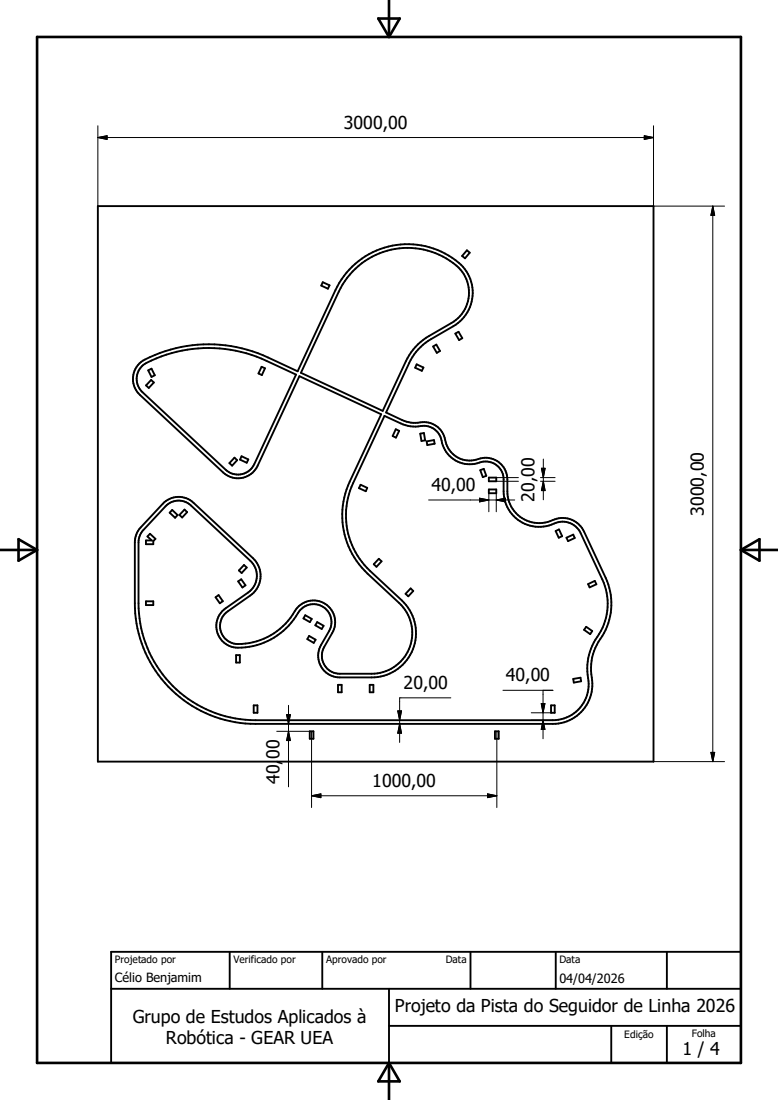
[picture p163: page 1]

Projetado por Célio Benjamim | Verificado por | Aprovado por Data | Data 04/04/2026

Robótica - GEAR UEA | Projeto da Pista do Seguidor de Linha 2026 Grupo de Estudos Aplicados à

Edição | Folha 1 / 4

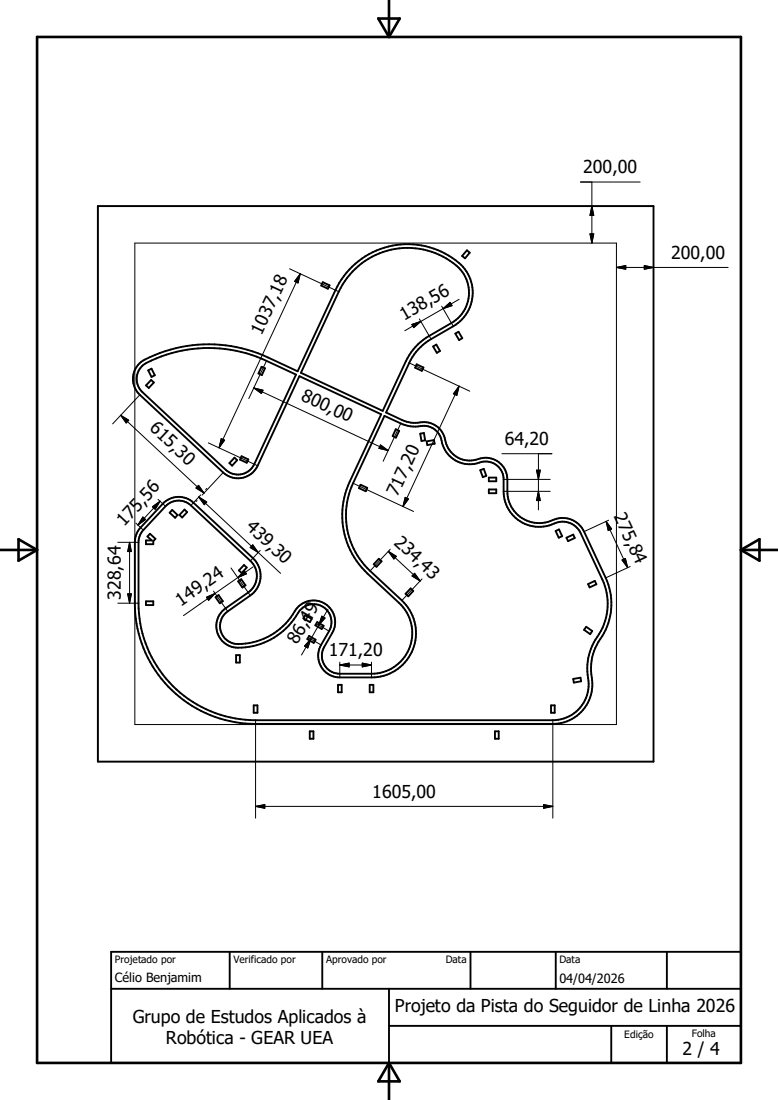
[picture p164: page 2]

Projetado por Célio Benjamim | Verificado por | Aprovado por Data | Data 04/04/2026

Projeto da Pista do Seguidor de Linha 2026 Grupo de Estudos Aplicados à

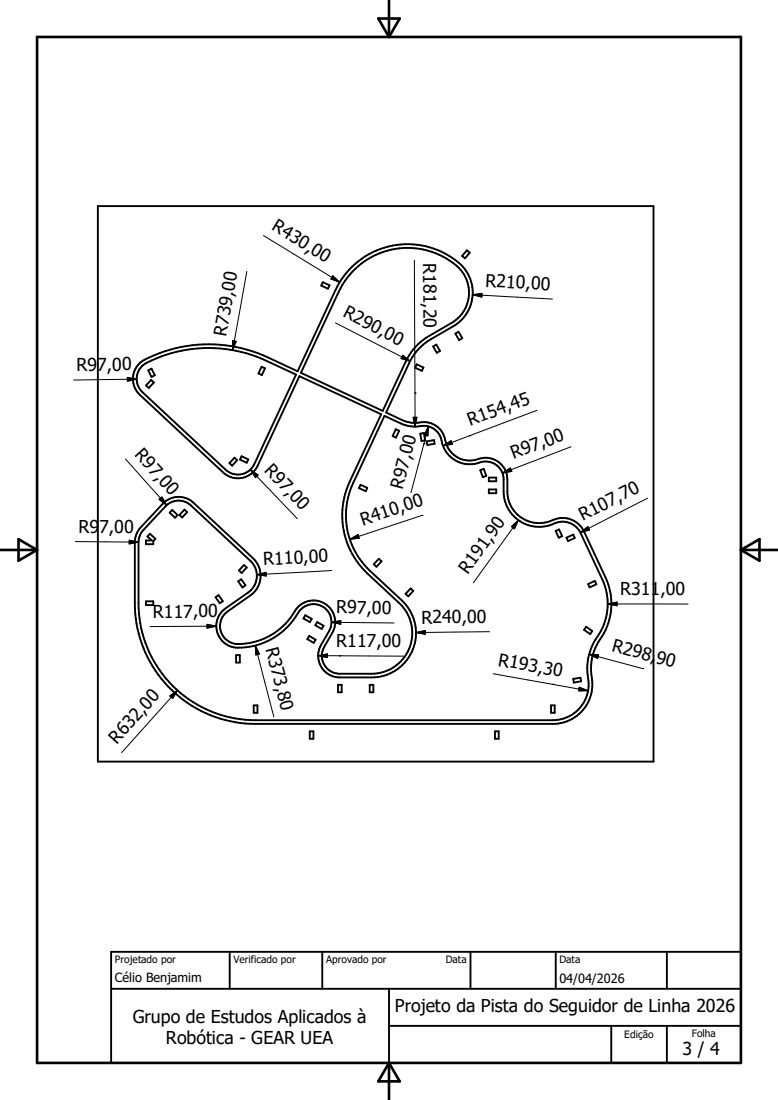
[picture p165: page 3]

Projetado por Célio Benjamim | Verificado por | Aprovado por Data | Data 04/04/2026

Projeto da Pista do Seguidor de Linha 2026 Grupo de Estudos Aplicados à

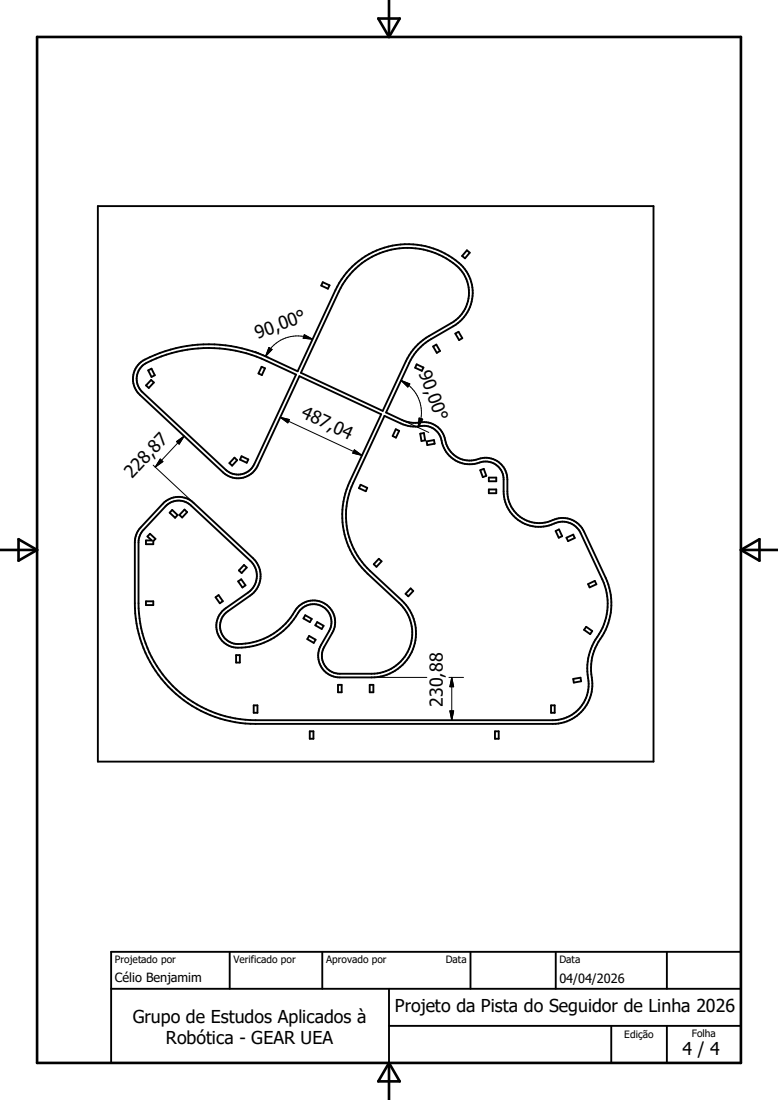
[picture p166: page 4]
Data ²³⁰,88

Projetado por Célio Benjamim | Verificado por | Aprovado por | Data 04/04/2026

Projeto da Pista do Seguidor de Linha 2026 Grupo de Estudos Aplicados à
