GEAR-EST/SEGUIDOR-2026/mechanics/3d_model/V3/ZeGuia/Placa/Dimensoes Placa.pdf

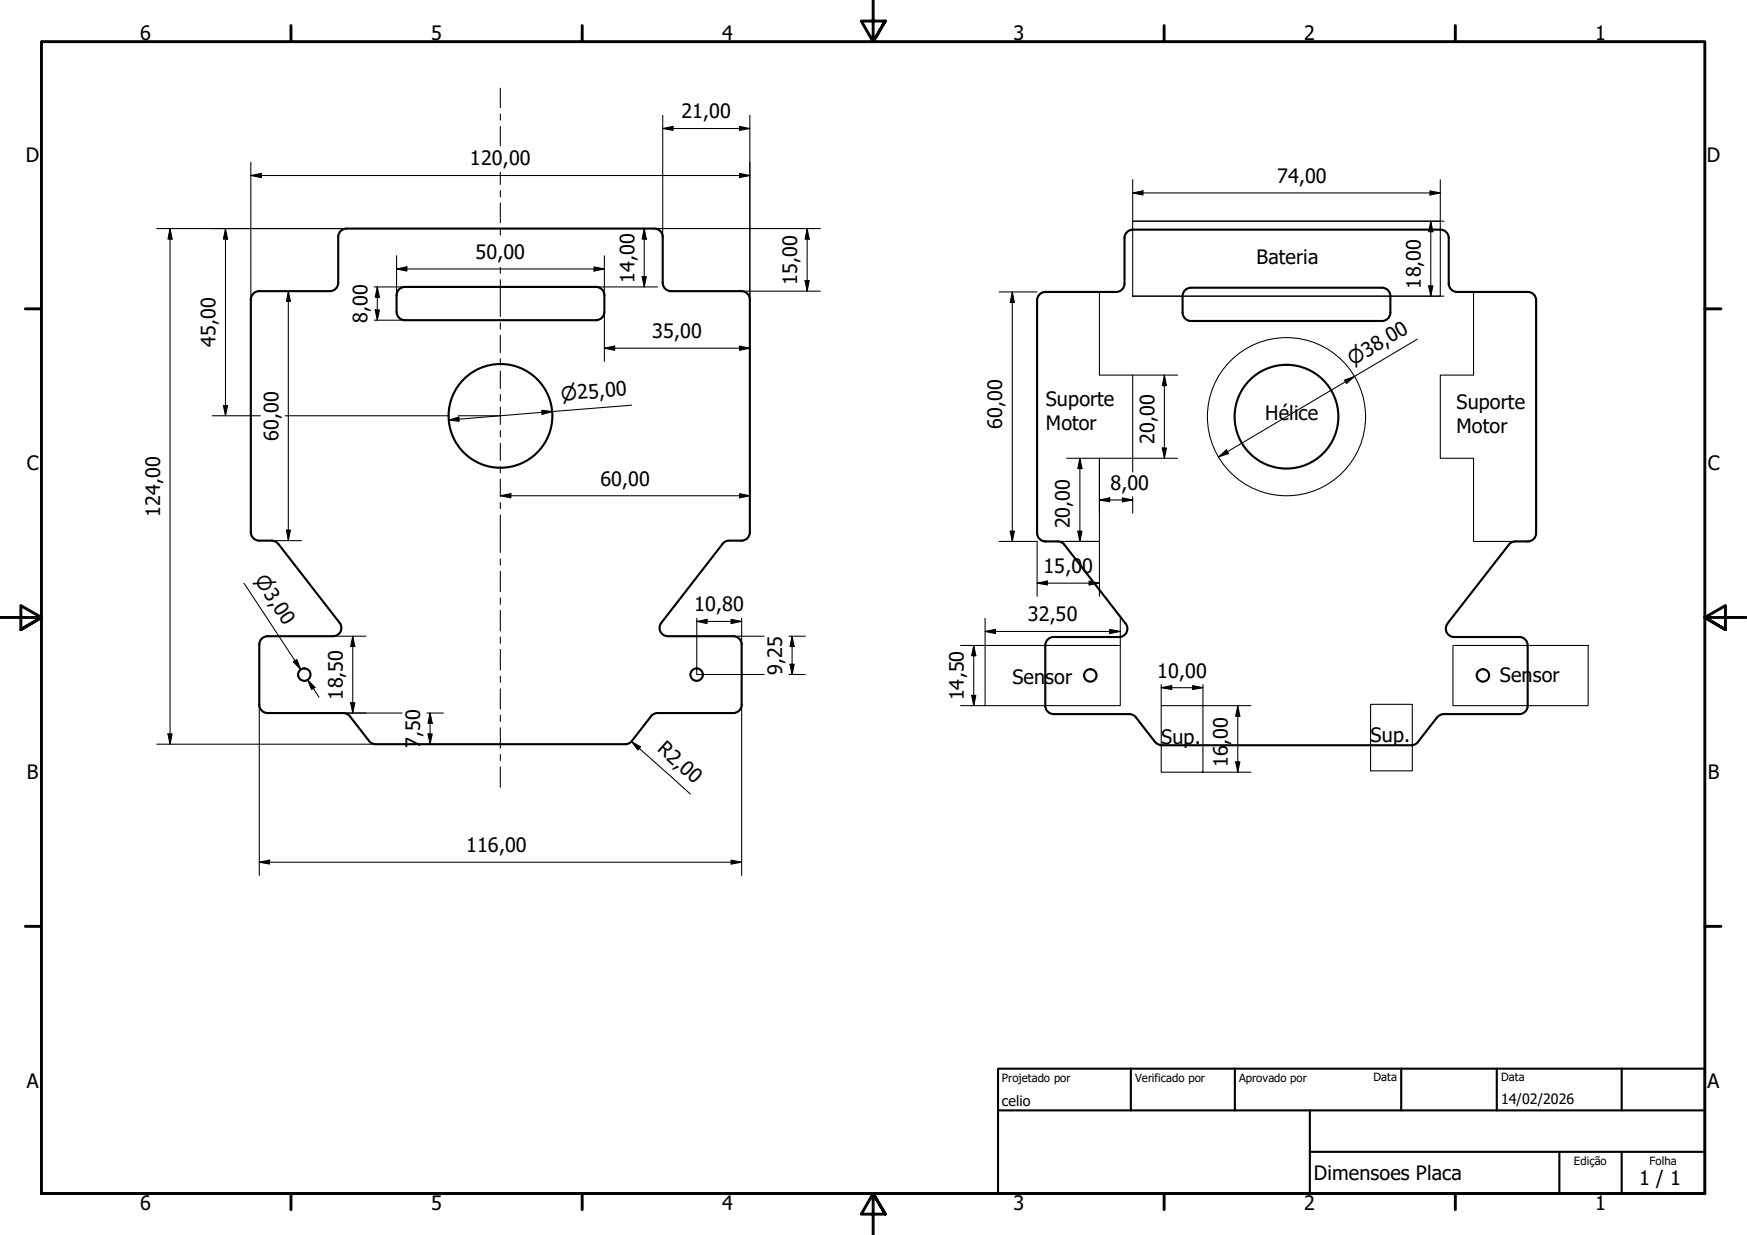
[picture p167: page 1]
Dimensoes Placa; Projetado por; Verificado por; Aprovado por; Data
