GEAR-EST/SEGUIDOR-2026/code/include/sensors.h

#pragma once

#include <QTRSensors.h>
#include <Preferences.h>

#define RightSensor 16
#define LeftSensor 17

#define EMPTY_VALUE 65535

#define LED_BUILTIN 2

#define D1_PIN 34
#define D2_PIN 35
#define D3_PIN 32
#define D4_PIN 33
#define D5_PIN 25
#define D6_PIN 26
#define D7_PIN 27
#define D8_PIN 14

//34, 35, 32, 33, 25, 26, 27, 14

const uint8_t SensorCount = 8;

extern Preferences preferences;
extern QTRSensors qtr;
extern uint16_t sensorValues[SensorCount];
extern uint16_t readRight;
extern uint16_t readLeft;

void setup_qtr();

void setup_side_sensors();

void side_sensors_print();

void doCalibration();

bool readCalibration();
