GEAR-EST/SEGUIDOR-2026/(commit log)

2026-01-14 docs(estudos): adicionada seção de estudos para coleta de informações e estudos da equipe
2026-01-14 docs(editais): adiciona os editais das competições (seguidor e perseguidor) para mais fácil acesso à informação
2026-01-14 docs(estudos): adicionada a seção de inspirações e algumas imagens de auxilio para a seção
2026-01-14 docs(estudos): adiciona o gif do seguidor de linha
2026-01-14 docs(inspirações): adiciona as inspirações, equipes famosas e outras referências importantes para estudos do seguidor
2026-01-14 fix(outras referências): mudança de link para o pdf
2026-01-14 feat(downforce): adiciona link do vídeo de sucção
2026-01-14 docs(estudos): adiciona o diretório de eletrônica com alguns componentes essenciais
2026-01-14 docs(estudos): adiciona o diretório de lógica e controle para ser preenchido posteriormente
2026-01-15 docs(estudos): mudança de nomeclatura quanto ao tipo de PID
2026-01-15 docs(estudos): adiciona informações de estudos e mais informações para adicionar sobre a lógica de funcionamento
2026-01-15 docs(estudos): adicionada informações e guia de estudos acerca da eletrônica e principais componentes
2026-01-15 docs(estudos): adição do link para o projeto do seguidor de linha do ano de 2025
2026-01-15 docs(media): adiciona as imagens utilizadas nos artigos de estudo
2026-01-21 style(estudos-pcb): muda estilo da página de PCB para melhor visualização
2026-01-27 docs(estudos-eletronica) : adiciona estudo inicial sobre dimensionamento de potência
2026-01-28 Adiciona estudo introdutório sobre ferramentas EDA
    Expanded the EDA study document with detailed insights on EasyEDA, KiCAD, and Proteus, including their features, advantages, and learning curves.
2026-01-28 Corrigi alguns erros que eu tinha escrito na parte EDA
2026-01-28 Adiciona estudo de cálculo de dimensionamento de trilhas para alta corrente em PCB
2026-01-29 Finaliza estudo sobre dimensionamento de potência e malhas de aterramento em PCB
2026-01-29 docs: adiciona estudo sobre proteção contra ruído em motores e desacoplamento do driver TB6612FNG
    Added detailed explanation on noise protection for motors using decoupling capacitors, including their placement and specifications for the TB6612FNG driver.
2026-01-30 docs(estudos-programacao-dev2) adicionar informações estudadas de FSM
2026-01-31 docs(estudos-programacao-dev2): mais informações de FreeRTOS e adição codigo teste
2026-01-31 docs(estudos-interface): adição de estudos sobre o bluetooth no esp32
2026-01-31 fix(estudos-interface): conserto de um link
2026-01-31 docs(estudos-interface): adição de informações sobre Serial Bluetooth Monitor
2026-02-02 docs(/docs): modifica o readme de /docs para corresponder ao template
    Updated project name and description in README.
2026-02-03 docs(componentes): atualiza lista de componentes do projeto
2026-02-06 docs(estudos): adicionando implementação de controle PID e sensores qtr
2026-02-12 docs(estudos-fsm-interface): esqueleto codigo teste de FSM
2026-02-13 docs(Ventoinha.md): Comecei o estudo sobre ventoinha
    Documentação sobre o motor coreless 8523 e uso do MOSFET IRLZ44N em robôs.
2026-02-14 docs(Ventoinha) Finalizei o estudo sobre ventoinha
    Explicação sobre a importância do diodo flyback na proteção do circuito e do MOSFET, além de recomendações sobre como conectá-lo corretamente e quais modelos utilizar.
2026-02-14 feat(estudos/codes): implementa o preferences no código de controle dos sensores laterais e qtr-8rc
2026-02-14 feat(mechanics): adiciona a versão 1 do seguidor. Serve como base para a construção da PCB
    [0603 cap.ipt, 0603 resistor.ipt, 1.ipt, 103 SMD.ipt, 12GA.ipt, 14GA.ipt, 1_Male_Pin_2.54_mm.ipt, 1x1.iam]
2026-02-17 feat(code): construção do código da task ControlsTask com o controls.cpp e controls.h implementando o que estava no implementação_qtr8rc_preferences, ajustando o que fora necessário para o freeRTOS +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
    [communication.h, controls.cpp, implementacao_qtr8rc.ino, implementacao_qtr8rc_preferences.ino, main.cpp]
2026-02-17 feat(include): adicionando pinout da motor driver
2026-02-17 refactor(code): enxugamento do arquivo controls.cpp para ficar dedicado às funções setup e loop próprias, transferindo funções de rotina do sensor QTR para o arquivo sensors.cpp, necessário uma avali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
2026-02-17 feat(code): parte da tentativa de implementar o controlador PID para criar rotinas para o motor driver (NÃO fazer merge, ainda não concluído, commitado somente para acesso remoto em outra máquina)
2026-02-18 docs(media): adiciona imagem atualizada esp32
2026-02-18 docs(media): adiciona imagem dos sensores laterais
2026-02-18 docs(media): adiciona imagem de pinout resistores
2026-02-18 docs(pinout): adiciona e atualiza pinout dos componentes
    Added various pinout diagrams for components including ESP32, TB6612FNG, LiPo battery, QTR-8RC sensor, TCRT5000, N20 motor, Coreless motor, IRLZ44N MOSFET, 1N4007 diode, switch, ceramic and electrolytic capacitors, and resistors.
2026-02-19 feat(code&interface): conexão bluetooth com o aplicativo para celular com kotlin
2026-02-23 feat(code-communication): Adição de comandos calibrar, começar e finalizar e serial monitor no aplicativo
2026-02-24 feat(mechanics): adiciona os modelos 3D em STL para impressão, das engrenagens de transmissão 4x2 e do suporte do motor e rodas
    [Engrenagem reta Motor.stl, Engrenagem reta Roda.stl, Suporte.stl]
2026-02-24 feat(mechanics): adiciona a montagem e versões anteriores do sistema de transmissão 4x2
    [4x2.0009.iam, 4x2.iam, Engrenagem reta11.ipt, Engrenagem reta12.ipt, Engrenagem reta14.ipt, Engrenagem reta15.ipt, Engrenagem reta17.0003.ipt, Engrenagem reta17.ipt]
2026-02-24 feat(mechanics): adiciona a última versão da montagem do modelo 3D do seguidor
    [Montagem Ze Guia.0012.iam, Montagem Ze Guia.iam]
2026-02-25 docs(estudos-interface): redefinição do diagrama de FSM
2026-02-25 docs(estudos-interface): versão 3 do diagrama de FSM
2026-02-27 fix(code): consertando bugs em motordrive.cpp
    [controls.cpp, motordriver.cpp, motordriver.h]
2026-03-01 feat(code-zeguiapp): melhoramento da interface com todos comandos e card de informações
2026-03-04 fix(code): consertando funcionalidades de sensor frontal e laterais, tornando totalmente funcional. (foi testado)
    [controls.cpp, motordriver.cpp, sensors.cpp, sensors.h]
2026-03-06 test(code/src/controls.cpp): testa motores pwm de motores em bancada
2026-03-07 docs(eletronics): atualização parcial do readme de eletronics
    Expand the README with detailed information about the electronics development for the SEGUIDOR-2026 robot project, including system architecture, components used, pinouts, and PCB specifications.
2026-03-07 docs(eletronics): adiciono placa pcb camada Top
2026-03-07 docs(eletronics): adiciona imagem da PCB Bottom
2026-03-08 docs(eletronics): adiciona primeira versão da pcb
2026-03-08 docs(eletronics): atualização parcial do readme de eletronics v2
2026-03-10 refactor(interface-zeguiaapp): att do layout pra abarcar modo e estrategia e att das informações e seleçao de botoes conforme a FSM
2026-03-10 refactor(interface-zeguiaapp): att do layout pra abarcar modo e estrategia e att das informações e seleçao de botoes conforme a FSM (parte 2)
2026-03-11 fix(code/motordriver.cpp): consertando bug na função lineBlack()
    [controls.cpp, main.cpp, motordriver.cpp, motordriver.h, pid.cpp, pid.h]
2026-03-11 test(code): testando pid
2026-03-22 feat(interface-zeguiaapp): adição do layout de editar parametros, bateria e cronometro
2026-03-22 feat(interface-zeguiapp): adição da tela de editar parametros
2026-03-22 feat(interface-zeguiaapp): adicao da tela de editar parametros (pt2)
2026-03-22 feat(code): implementa leitura da bateria (valor cru e porcentagem) + refactor(code/motordrive): cria função dedicada a pinMode do motor drive para organizar controls.cpp
2026-03-25 feat(mechanics): adiciona nova versão (V2) do modelo 3D do robô seguidor de linha 2026
    [0603 cap.ipt, 0603 resistor.ipt, 1.ipt, 103 SMD.ipt, 12GA.ipt, 14GA.ipt, 1_Male_Pin_2.54_mm.ipt, 1x1.iam]
2026-03-25 feat(mechanics): adiciona os arquivos STL para impressão 3D
    [Engrenagens motor.stl, Engrenagens rodas.stl, Helice.stl, Sup_haste_corpo.stl, Sup_haste_sensor_D.stl, Sup_haste_sensor_E.stl, Sup_motor_coreless.stl, Suporte Motor e Rodas.stl]
2026-03-25 feat(code-communication): enviando dados da bateria para o aplicativo
2026-03-27 fix(code): consertando o código do mapeamento da tensão da bateria pelo divisor de tensão (versão de teste ok)
    [controls.cpp]
2026-04-08 fix: consertando código da bateria, agora lançando uma função que retorna um valor inteiro de média de leitura do pino 13 em porcentagem
    [controls.cpp]
2026-04-08 refactor: refatoração dos códigos de controles, sensores e motores + fix: consertando rotinas de calibração
    [controls.cpp, motordriver.cpp, motordriver.h, sensors.cpp, sensors.h]
2026-04-08 test: testando bateria e união de controle e comunicação
2026-04-13 fix: consertando problemas de controle e medição de sensores + test: adiciona funcionalidades de teste com o celular
    [controls.cpp, motordriver.cpp, sensors.cpp, sensors.h, zeGuia.cpp]
2026-04-16 test(code\motordriver.cpp): teste do sistema de fail safe
    [motordriver.cpp, motordriver.h, zeGuia.cpp]
2026-04-20 refactor(interface): Atualização do layout do card de informações, parâmetros, bateria e cronômetro
2026-04-22 feat(interface-zeguiaapp): Adição do botão Sensores e reformulação do layout de cronometro, bateria, parametros e informacoes, led e bluetooth
2026-04-22 refactor(interface-zeguiapp): refatora o layout do app dos cards de informacoes
2026-04-30 feat(code-src): leitura dos sensores verdadeira para o app
2026-04-30 feat(interface-zeguiapp): leitura sensores verdadeiro para o app, layout de parametros na horizontal
2026-04-30 refactor: migrando funções de bateria para communication.cpp
2026-04-30 fix: consertando bug na função de bateria
    [communication.cpp, communication.h]
2026-05-04 feat(code-zeguia-comm): editar parametros de VelEsquerda e VelDireita com o app e marcas
2026-05-04 feat(interface-zeguiaapp): editar parametros de VelEsq VelDireita pelo app, contador de marcas e botão de exportar log do robô
2026-05-04 test: testando função motors_calibrate
2026-05-05 fix: adicionando localmente bibliotecas em /lib + test: fazendo mudanças para ajustar sensores frontais + fix: mudando lógica de calibração eliminando função motors_calibrate
    [motordriver.cpp, motordriver.h, sensors.cpp, sensors.h, zeGuia.cpp]
2026-05-05 fix: otimiza o tempo de calibração
    [sensors.cpp]
2026-05-05 fix(QTRSensors): modifica os valores de constantes para verificar se o sensor está na linha e o valor do ruído para considerar na média
2026-05-06 test: validando o pid fisicamente, mudando parâmetros das funções de seguir linha da biblioteca e da função lineWhite
2026-05-07 docs(img): deletar pinout incorreto dos resist
2026-05-07 docs(img): deletar pinout incorreto da esp32
2026-05-07 docs(img): deletar pinout incorreto dos capacitores
2026-05-07 docs(img): deletar pinout incorreto dos sensores laterais
2026-05-07 docs(img): deletar pinout incorreto dos capacitores dos mot.
2026-05-07 refactor: mudando variáveis long para uint32_t e realocando a função lineWhite() para a classe ZeGuia + fix: excluindo função qtr_print() + test: testando parada ativa e passiva além de tuning do PID
    [motordriver.cpp, motordriver.h, sensors.cpp, sensors.h, zeGuia.cpp, zeGuia.h]
2026-05-08 docs(img): Adiciona o pinout dos capacitores
2026-05-09 docs(eletronics): Atualizção parcial do readme de eletrônica
2026-05-09 docs(img): adiciona imagens da placa pcb chinesa e cnc
2026-05-09 docs(img): adiciona fotos de visão 3d das placas pcb chinesa
2026-05-09 docs(img): Adiciona imagem do esquemático da pcb no proteus
2026-05-09 docs(img): adiciona imagem da placa PCB CNC
2026-05-09 doca(img): adiciona imagens de erros na placa pcb
2026-05-09 docs(eletronics): atualização parcial do readme de eletronics
2026-05-09 docs(eletronics): atualização final do diretório de eletrônica
2026-05-11 test: testando lógica de parada na função markersCounter DISCLAIMER: versão com bugs na parada automática
    [zeGuia.cpp, zeGuia.h]
2026-05-13 fix(code-communication-zeguiapp): correções de texto repetido de calibração, cronometro e estado de calibracao
    [communication.cpp]
2026-05-13 fix(code-zeguia-comm): sincronizar a logica de parada com app e correção de erro da fila de comandos
    [communication.cpp, sensors.cpp, zeGuia.cpp]
2026-05-13 fix(interface-zeguiaapp): ajustes no cronometro, logica de parada ativa e layout dos sensores
2026-05-13 fix: versão estável do firmware por dev-1
    [motordriver.cpp, sensors.cpp, zeGuia.cpp, zeGuia.h]
2026-05-13 feat(code-comm): salvar parametros na esp32
2026-05-13 fix: tirei o uso do led da calibração
    [sensors.cpp]
2026-05-13 fix(code-zeguia-comm): remoção da velesq e dir
    [commands.h, communication.cpp, zeGuia.cpp, zeGuia.h]
2026-05-13 fix: mudanças leitura sensores
    [communication.cpp]
2026-05-13 fix(code-comm): testando leitura dos sensores
    [communication.cpp, communication.h, zeGuia.cpp]
2026-05-15 refactor(zeguia-app): retira de velesq, veldir, led do app, consertos para o funcionamento do parametros
2026-05-15 feat(zeguiapp): logica de mudança da esp32 no app, logo do gear e bluetooth verde
2026-05-15 test: mudando algumas coisas pra ver como o pid funciona
2026-05-18 feat(zeguia): grandes mudanças do layout para sincronizar com o figma, mas ainda não funcional
2026-05-18 test: testando lógica do tracejado
2026-05-19 feat(zeguia): adaptação do layout conforme o design do figma, configurar esp32 funcional, revisão de todas as funcionalidades.
2026-05-19 test: testando lógica de parada parte 2
2026-05-20 feat: implementa teste de lógica de tracejado funcionando parcialmente
2026-05-20 refactor(zeguia): mudanças no layout do modal de "Sobre nós", botão bluetooth, exportar, fontes e cores
2026-05-21 refactor(zeguia): mudanças no icone bluetooth com animacao e cor laranja para conectando, padronizacao cards no modal sobre nós, correções
2026-06-03 chore: aplicando parâmetros funcionais para linha preta
2026-06-03 fix: tirando variáveis inúteis
    [zeGuia.h]
2026-06-03 feat: modularizando a funcionalidade de tracejado
2026-06-03 docs: comentando o arquivo pid.cpp
2026-06-03 refactor: mudando algumas coisinhas na forma que os comentários estão formatados
2026-06-03 refactor: excluindo o arquivo globals.h e realocando as linhas para outros headers
2026-06-03 refactor: realocando a função setup de controls para setup de zeguia
2026-06-11 docs: comentando arquivo pid.cpp com doxygen tags
2026-06-11 docs: comentando arquivo sensors.cpp com doxygen tags
2026-06-11 refactor: mudando #ifndef para #pragma once
2026-06-11 docs: comentando motordriver.cpp com doxygen tags
2026-06-25 refactor(zeguia): modularização em helpers, limpeza de drawables/layouts obsoletos e atualização do firmware
    Extrai lógica de Bluetooth, cronômetro, exportação, sensores, parâmetros, ESP32,
    estado de UI e ícone Bluetooth para classes Helper dedicadas, reduzindo MainActivity
    de ~1400 para ~300 linhas. Remove drawables e layouts não utilizados, reorganiza
    mipmaps e atualiza communication.cpp com protocolo revisado.
2026-06-25 feat(zeguia): editar e excluir ESP32 no modal de configuração
    Adiciona botões de lápis e lixeira ao campo de dispositivo ativo no modal
    ESP32, com borda roxa unificada e dividers verticais conforme o design.
    Lápis abre dialog para editar o endereço MAC ativo; lixeira remove o
    dispositivo da lista salva (protege o último registro).
2026-06-25 feat(zeguia): edição inline e confirmação de exclusão no modal ESP32
    Lápis sem tint (cores nativas do ic_edit_pencil igual ao editar parâmetros).
    Clique no lápis revela seção inline "EDITAR MAC" com campo pré-preenchido e
    botão Salvar, sem abrir dialog separado. Lixeira exibe AlertDialog de
    confirmação com o MAC sendo excluído antes de remover da lista.
2026-06-25 feat(zeguia): dialog de confirmação de exclusão ESP32 com estética customizada
    Substitui AlertDialog padrão por layout próprio (dialog_excluir_esp.xml)
    com a mesma identidade visual do modal ESP32: fundo #130822, borda roxa,
    cantos 20dp, header com ícone lixeira vermelho + título, divider e MAC em
    destaque (verde). Botões CANCELAR (roxo) e EXCLUIR (vermelho) no rodapé.
2026-06-25 feat(zeguia): ocultar adicionar novo ao editar e igualar cor da lixeira ao lápis
    Cor da lixeira atualizada para #A040D8 (mesmo fill do ic_edit_pencil) e sem
    tint no ImageView, ficando idêntica visualmente ao ícone de editar. Ao clicar
    no lápis, a seção "ADICIONAR NOVO" é ocultada e reaparece ao salvar a edição
    ou confirmar exclusão.
2026-06-25 fix(zeguia): detectar desconexão inesperada e padronizar SharedPreferences
    - BluetoothHelper: ao sair do loop de leitura com continuarEscutando=true
    (queda de sinal/bateria), notifica onDisconnected() e desmarca o switch
    para permitir nova tentativa de conexão; guard em desconectar() evita
    dupla notificação
    - MainActivity: substituir edit().apply{apply()} por edit{} em onParams()
2026-06-28 docs(code): adiciona doxygen tags e documenta módulos de comunicação e ZeGuia em README
2026-06-28 docs(code): mais documentação no módulo de comunicação em README
2026-07-01 docs(eletronic): Adiciona imagem da pcb
2026-07-15 feat(mechanics): adiciona a V3 da parte mecânica do seguidor
    [0603 cap.ipt, 0603 resistor.ipt, 1.ipt, 103 SMD.ipt, 12GA.ipt, 14GA.ipt, 1_Male_Pin_2.54_mm.ipt, 1x1.iam]
2026-07-15 docs(mechanics): atualiza o readme para adicionar as imagens da montagem física
2026-07-30 fix: consertando pequenos bugs que se originaram de conflitos de merge
    [main.cpp, zeGuia.h]
2026-07-30 fix: excluindo readme de lib
2026-07-30 docs: modificando minha parte do readme de code
2026-08-03 fix: consertando erro de lógica no arquivo main que impossibilitava a ativação das task do sistema operacional
    [main.cpp]
